Merophy/pectoralis_major/Documents/merophidae-downstroke.jpeg

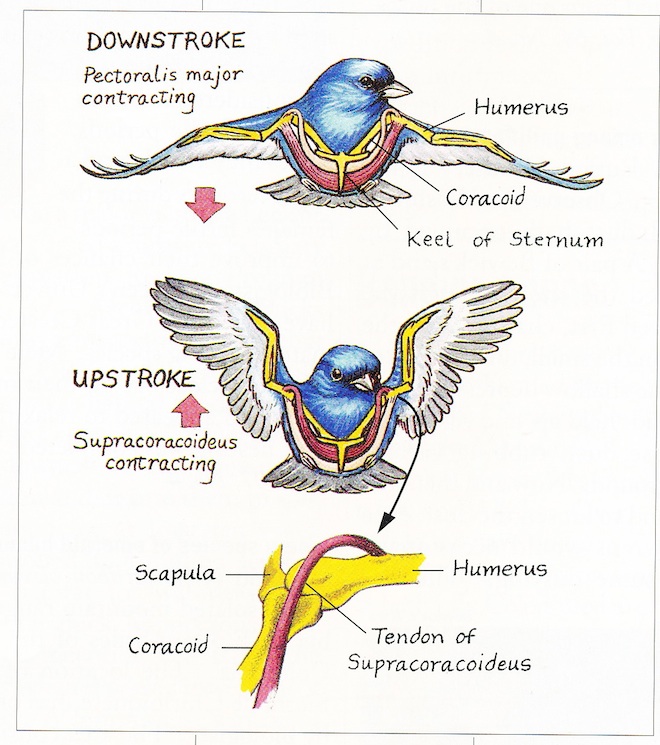
Documents/merophidae-downstroke.jpeg
