Merophy/pectoralis_major/Documents/proprioception.jpeg

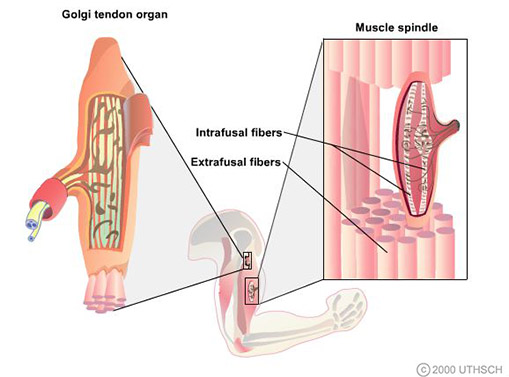
Documents/proprioception.jpeg
