Merophy/pectoralis_major/README.md

# pectoralis_major
The pectoralis is a large muscle that attaches to the humerus of the wing at the deltopectoral crest.
