Merophy/pectoralis_major/Documents/Neuromuscular_junction.jpeg

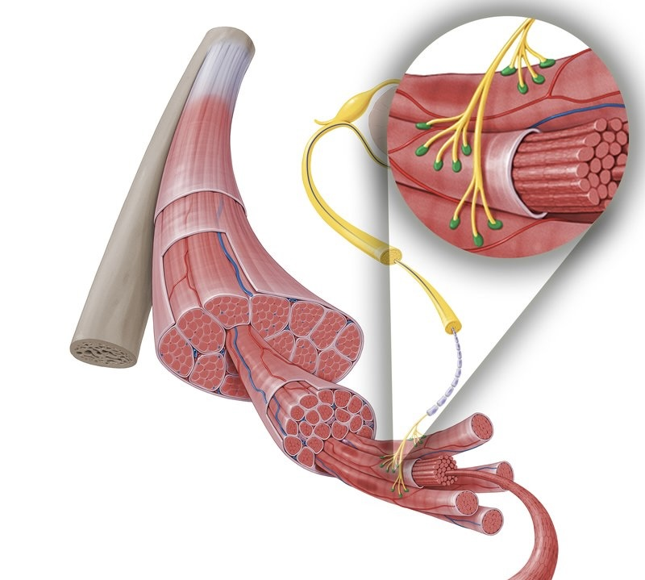
Documents/Neuromuscular_junction.jpeg
