Merophy/pectoralis_major/Circuit Designs/foc.DXF

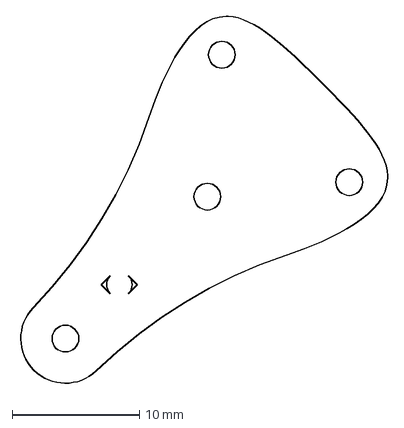
[picture p4: CAD file, 2022-03-30]
Circuit Designs/foc.DXF
29.1 x 29.1 mm
