Merophy/pectoralis_major/Circuit Designs/pectoralis_major.step

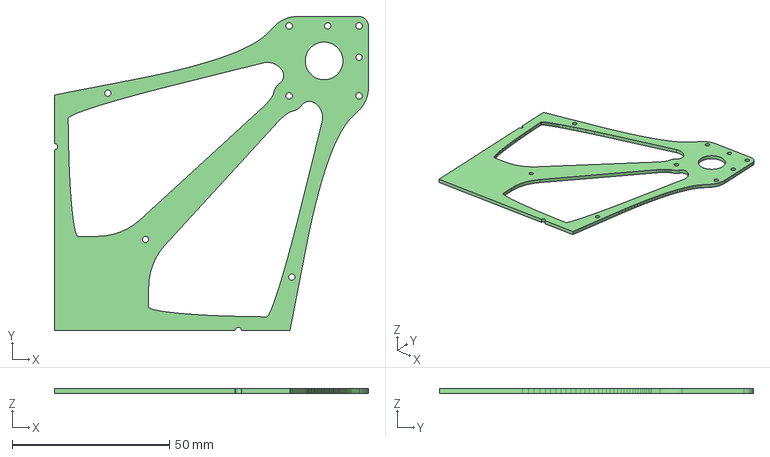
[picture p5: CAD file, 2022-03-06]
Circuit Designs/pectoralis_major.step
100.0 x 100.0 x 1.60 mm
