Merophy/pectoralis_major/Circuit Designs/esc.DXF

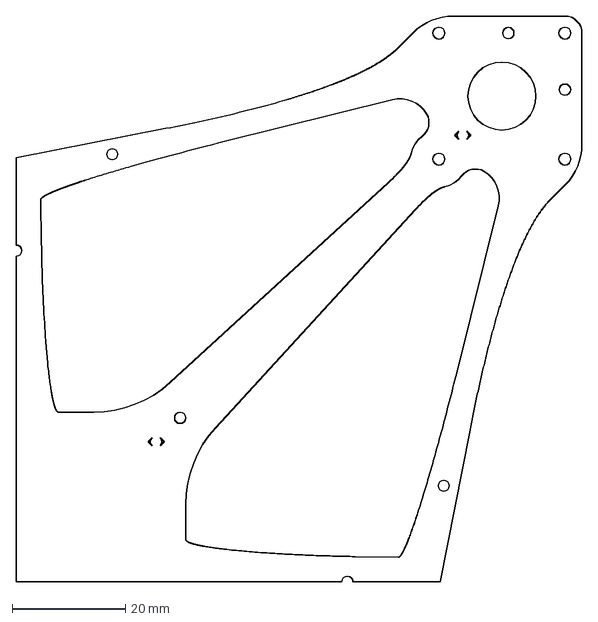
[picture p6: CAD file, 2022-03-06]
Circuit Designs/esc.DXF
100.0 x 100.0 mm
