Merophy/pectoralis_major/Circuit Designs/pectoralis_major.kicad_pcb

## KiCad design Circuit Designs/pectoralis_major.kicad_pcb (2022-04-14)

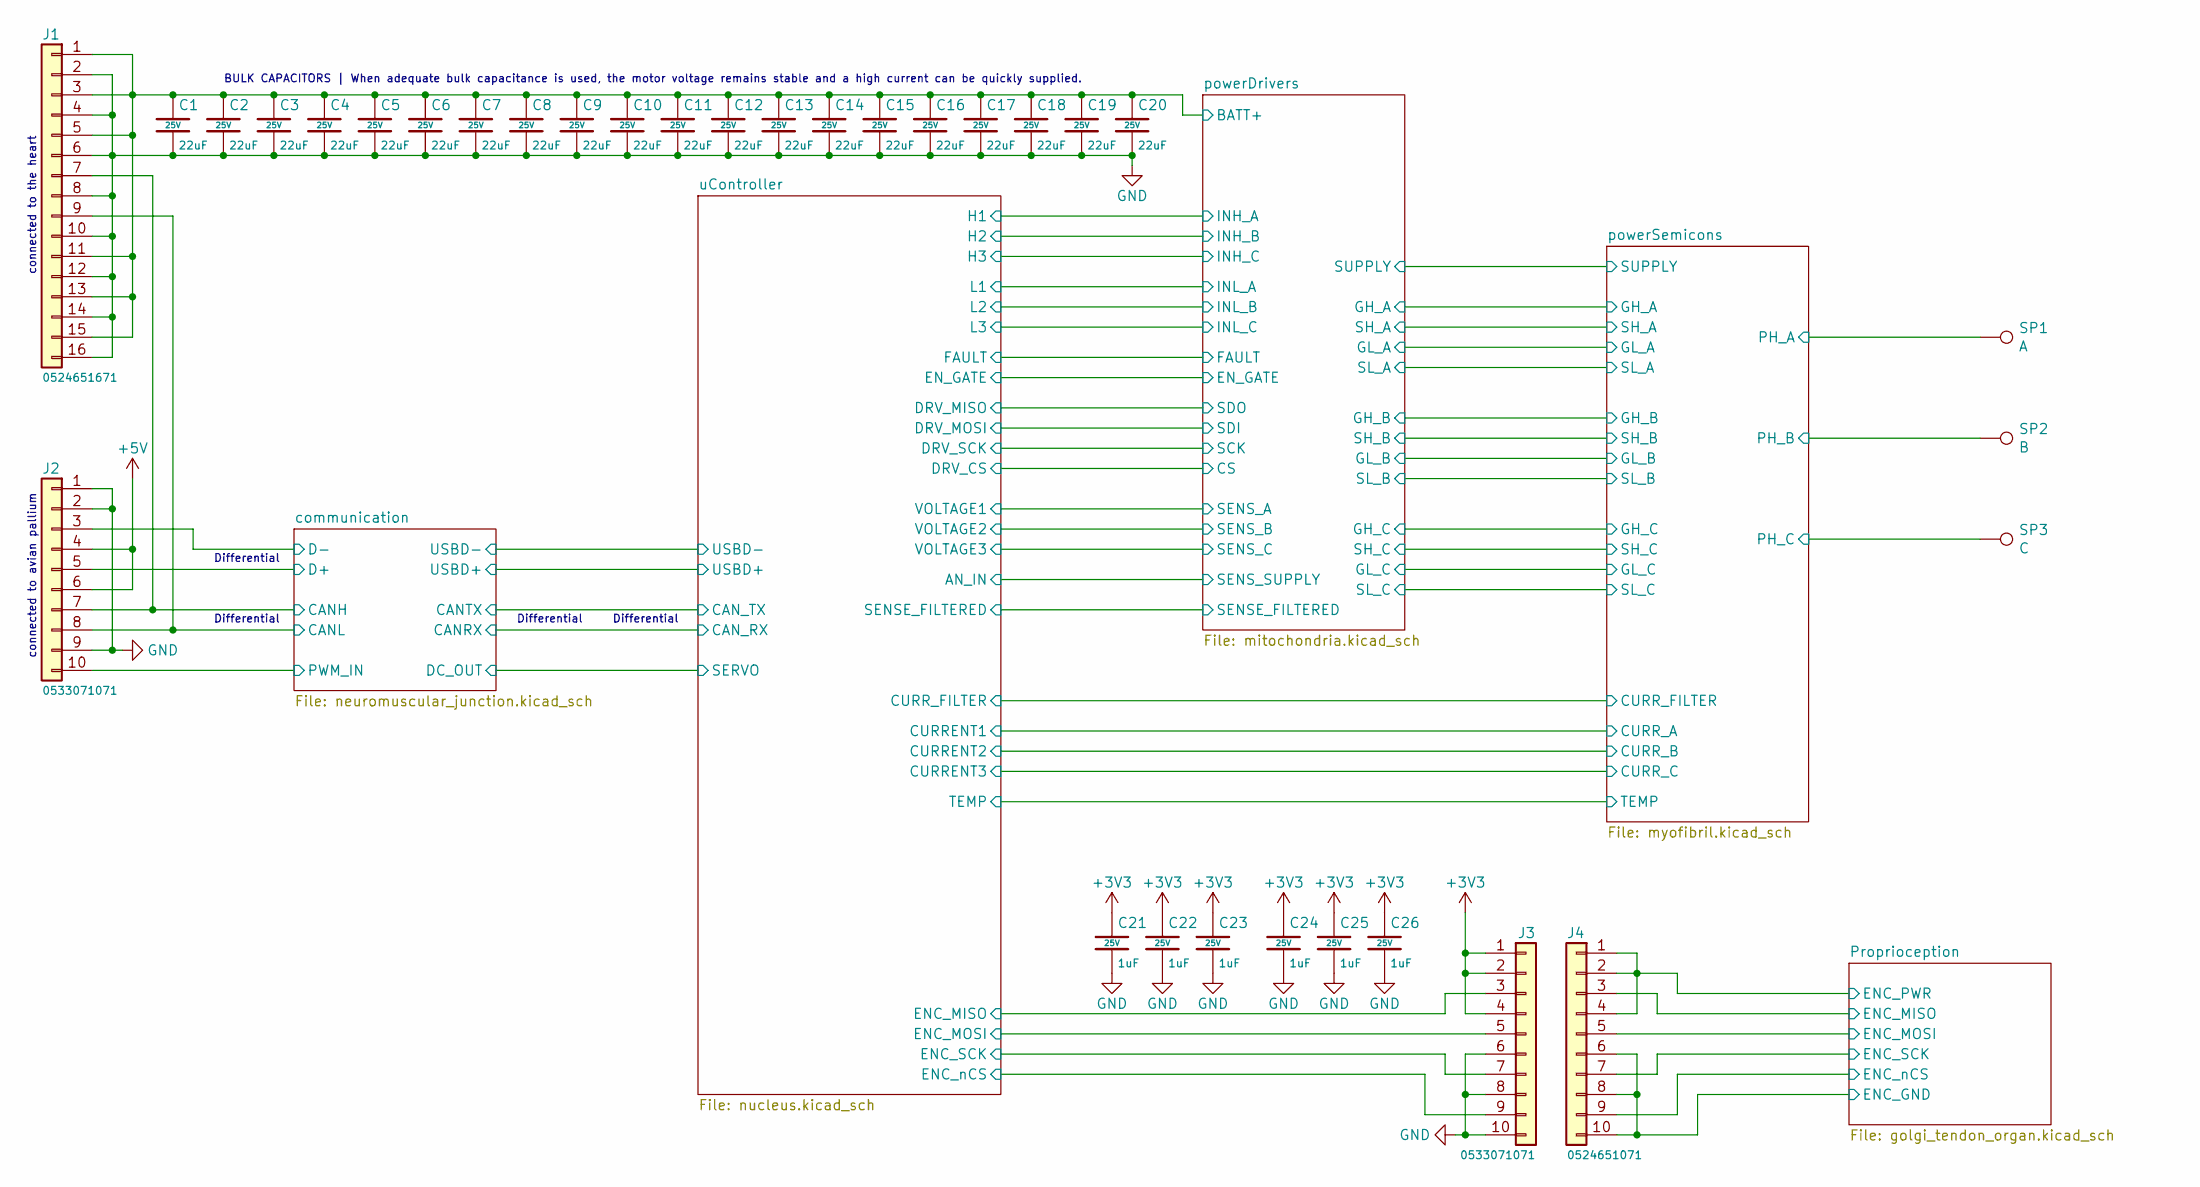
[picture p7: schematic pectoralis_major.kicad_sch, pectoralis major]

Parts:
C1, C2, C3, C4, C5, C6, C7, C8, C9, C10, C11, C12, C13, C14, C15, C16, C17, C18, C19, C20: 22uF; C-0805; Voltage 25V; MFR. Part # CL21A226MAQNNNE; JLCPCB Part # C45783
C21, C22, C23, C24, C25, C26: 1uF; C-0402; Voltage 25V; MFR. Part # CL05A105KA5NQNC; JLCPCB Part # C52923
J1: 0524651671; 524651671; MFR Part # 0524651671; Digikey Part # WM7089CT-ND
J2, J3: 0533071071; MFR Part # 0533071071; Digikey Part # WM8918CT-ND
J4: 0524651071; 524651071; MFR Part # 0524651071; Farnell Part # 2063791
SP1: A; SolderPt_2.5x4mm
SP2: B; SolderPt_2.5x4mm
SP3: C; SolderPt_2.5x4mm

Connections:
+3V3: C21.1, C22.1, C23.1, C24.1, C25.1, C26.1, J3.1, J3.2, J3.4; also elsewhere on the board
+5V: J2.4, J2.6; also elsewhere on the board
/Proprioception/ENC_GND: J4.6, J4.8, J4.10; also elsewhere on the board
/Proprioception/ENC_MISO: J4.3; also elsewhere on the board
/Proprioception/ENC_MOSI: J4.5; also elsewhere on the board
/Proprioception/ENC_PWR: J4.1, J4.2, J4.4; also elsewhere on the board
/Proprioception/ENC_SCK: J4.7; also elsewhere on the board
/Proprioception/ENC_nCS: J4.9; also elsewhere on the board
/communication/CANH: J1.7, J2.7; also elsewhere on the board
/communication/CANL: J1.9, J2.8; also elsewhere on the board
/communication/D+: J2.5; also elsewhere on the board
/communication/D-: J2.3; also elsewhere on the board
/communication/PWM_IN: J2.10; also elsewhere on the board
/powerSemicons/PH_A: SP1.1; also elsewhere on the board
/powerSemicons/PH_B: SP2.1; also elsewhere on the board
/powerSemicons/PH_C: SP3.1; also elsewhere on the board
/uController/ENC_MISO: J3.3; also elsewhere on the board
/uController/ENC_MOSI: J3.5; also elsewhere on the board
/uController/ENC_SCK: J3.7; also elsewhere on the board
/uController/ENC_nCS: J3.9; also elsewhere on the board
GND: C1.2, C2.2, C3.2, C4.2, C5.2, C6.2, C7.2, C8.2, C9.2, C10.2, C11.2, C12.2, C13.2, C14.2, C15.2, C16.2, C17.2, C18.2, C19.2, C20.2, C21.2, C22.2, C23.2, C24.2, C25.2, C26.2, J1.2, J1.4, J1.6, J1.8, J1.10, J1.12, J1.14, J1.16, J2.1, J2.2, J2.9, J3.6, J3.8, J3.10; also elsewhere on the board
PVDD2: C1.1, C2.1, C3.1, C4.1, C5.1, C6.1, C7.1, C8.1, C9.1, C10.1, C11.1, C12.1, C13.1, C14.1, C15.1, C16.1, C17.1, C18.1, C19.1, C20.1, J1.1, J1.3, J1.5, J1.11, J1.13, J1.15; also elsewhere on the board

Notes on the sheet:
Differential
BULK CAPACITORS | When adequate bulk capacitance is used, the motor voltage remains stable and a high current can be quickly supplied.
connected to avian pallium
connected to the heart

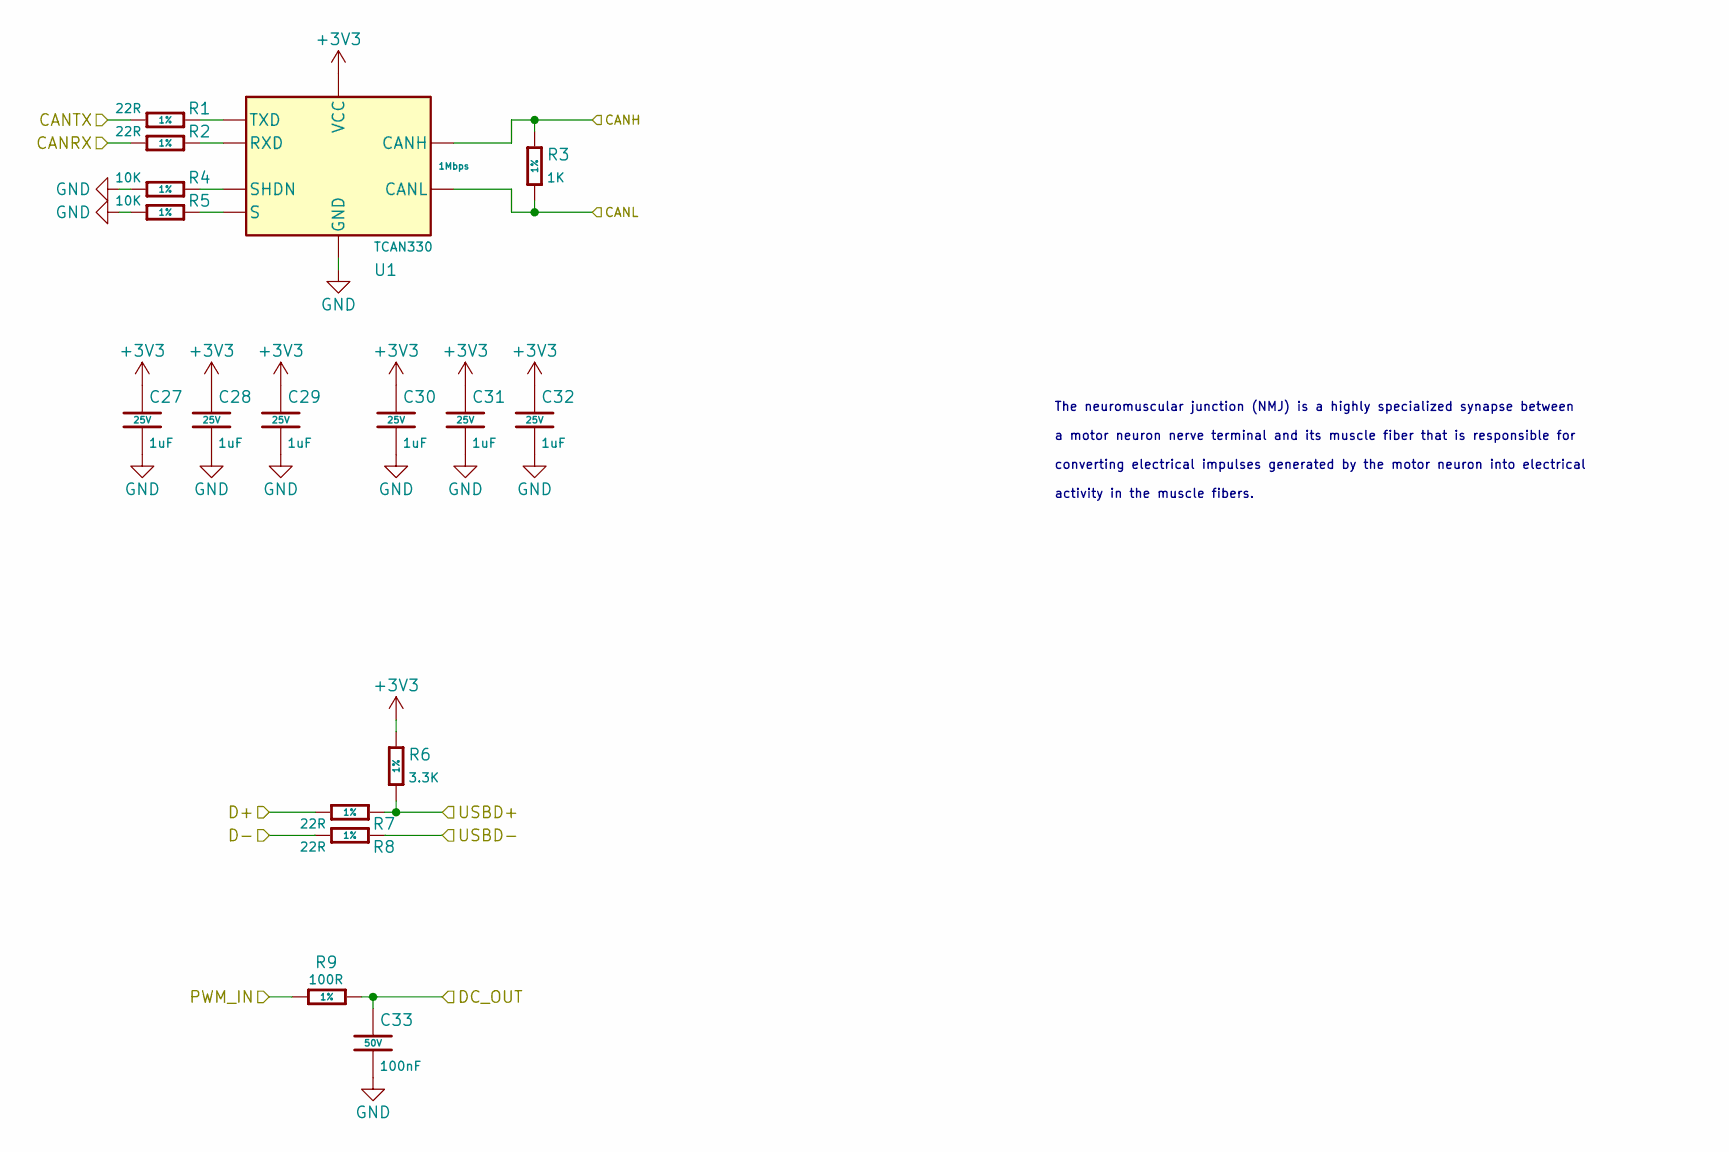
[picture p8: schematic neuromuscular_junction.kicad_sch, pectoralis major]

Parts:
C27, C28, C29, C30, C31, C32: 1uF; C-0402; Voltage 25V; MFR. Part # CL05A105KA5NQNC; JLCPCB Part # C52923
C33: 100nF; C-0402; Voltage 50V; MFR. Part # CL05B104KB54PNC; JLCPCB Part # C307331
R1, R2, R7, R8: 22R; R-0402; Tolerance 1%; MFR. Part # 0402WGF220JTCE; JLCPCB Part # C25092
R3: 1K; R-0402; Tolerance 1%; MFR. Part # 0402WGF1001TCE; JLCPCB Part # C11702
R4, R5: 10K; R-0402; Tolerance 1%; MFR. Part # 0402WGF1002TCE; JLCPCB Part # C25744
R6: 3.3K; R-0402; Tolerance 1%; MFR. Part # 0402WGF3301TCE; JLCPCB Part # C25890
R9: 100R; R-0402; Tolerance 1%; MFR. Part # 0402WGF1000TCE; JLCPCB Part # C25076
U1: TCAN330; TSOT-23-8; MFR. Part # TCAN330GDCNR; Digikey Part # 296-TCAN330GDCNRCT-ND

Connections:
+3V3: C27.1, C28.1, C29.1, C30.1, C31.1, C32.1, R6.1, U1.3 (VCC); also elsewhere on the board
/communication/CANH: R3.1, U1.7 (CANH); also elsewhere on the board
/communication/CANL: R3.2, U1.6 (CANL); also elsewhere on the board
/communication/CANRX: R2.1; also elsewhere on the board
/communication/CANTX: R1.1; also elsewhere on the board
/communication/D+: R7.1; also elsewhere on the board
/communication/D-: R8.1; also elsewhere on the board
/communication/DC_OUT: C33.1, R9.2; also elsewhere on the board
/communication/PWM_IN: R9.1; also elsewhere on the board
/communication/USBD+: R6.2, R7.2; also elsewhere on the board
/communication/USBD-: R8.2; also elsewhere on the board
GND: C27.2, C28.2, C29.2, C30.2, C31.2, C32.2, C33.2, R4.1, R5.1, U1.2 (GND); also elsewhere on the board
unnamed: R1.2, U1.1 (TXD)
unnamed: R2.2, U1.4 (RXD)
unnamed: R4.2, U1.5 (SHDN)
unnamed: R5.2, U1.8 (S)

Notes on the sheet:
The neuromuscular junction (NMJ) is a highly specialized synapse between a motor neuron nerve terminal and its muscle fiber that is responsible for converting electrical impulses generated by the motor neuron into electrical activity in the muscle fibers.

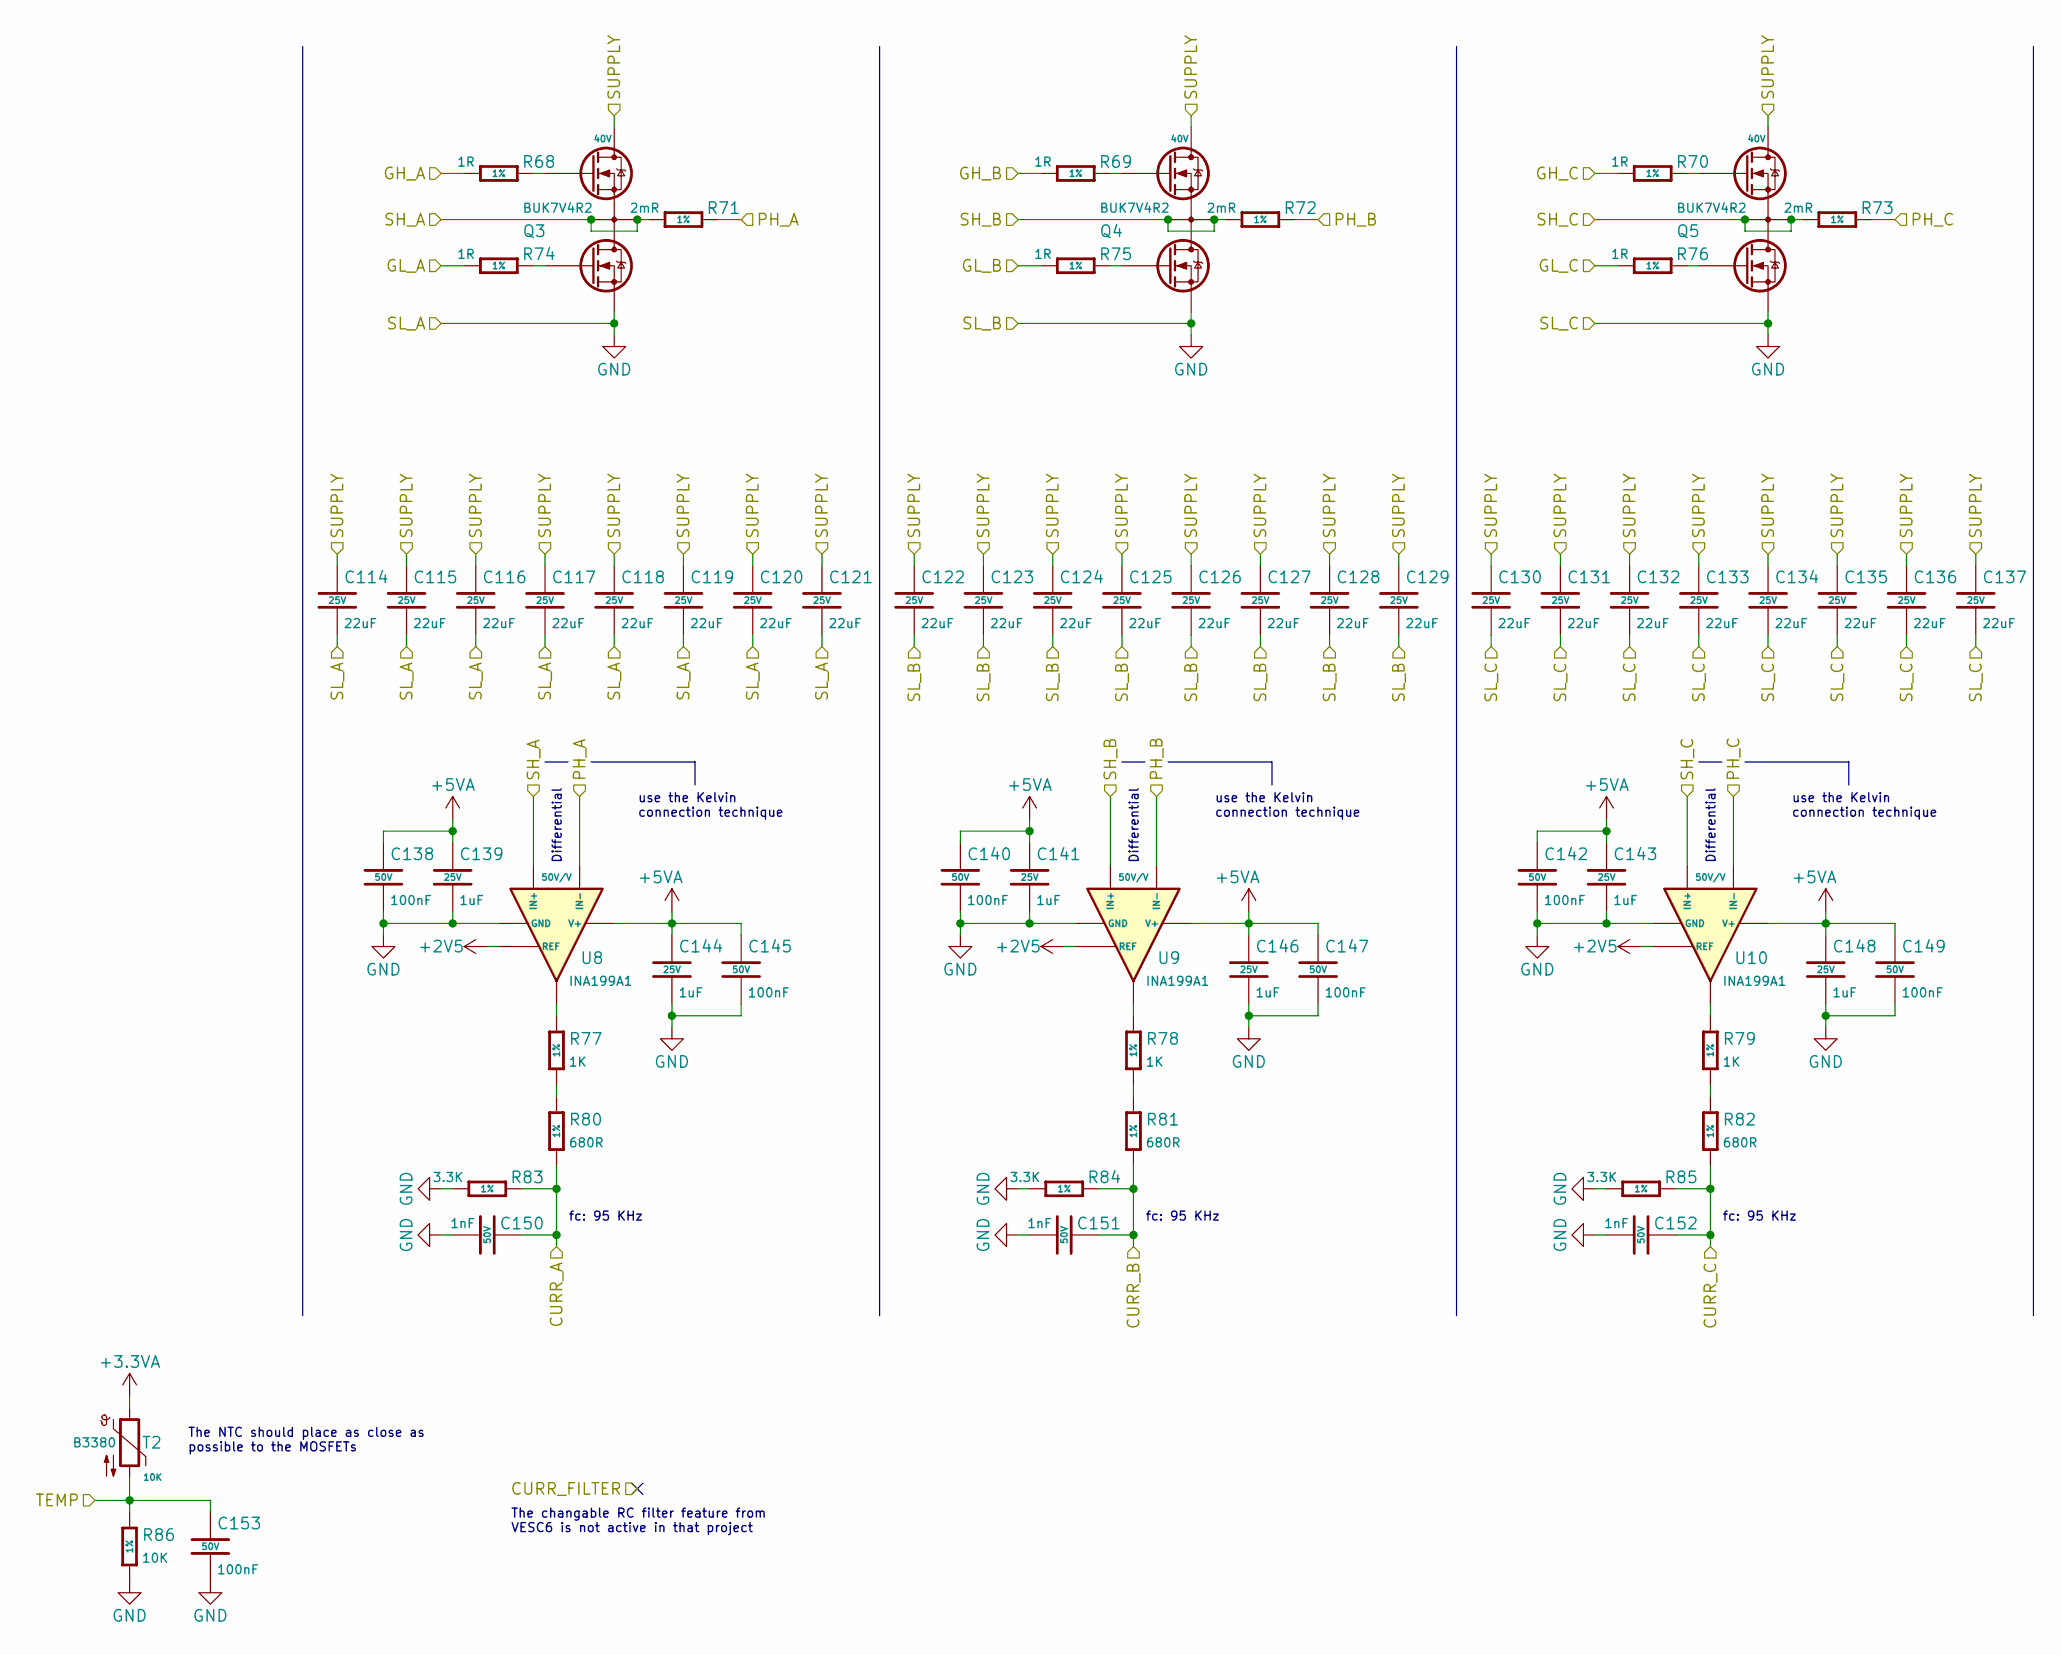
[picture p9: schematic myofibril.kicad_sch, pectoralis major]

Parts:
C114, C115, C116, C117, C118, C119, C120, C121, C122, C123, C124, C125, C126, C127, C128, C129, C130, C131, C132, C133, C134, C135, C136, C137: 22uF; C-0805; Voltage 25V; MFR. Part # CL21A226MAQNNNE; JLCPCB Part # C45783
C138, C140, C142, C145, C147, C149, C153: 100nF; C-0402; Voltage 50V; MFR. Part # CL05B104KB54PNC; JLCPCB Part # C307331
C139, C141, C143, C144, C146, C148: 1uF; C-0402; Voltage 25V; MFR. Part # CL05A105KA5NQNC; JLCPCB Part # C52923
C150, C151, C152: 1nF; C-0402; Voltage 50V; MFR. Part # 0402B102K500NT; JLCPCB Part # C1523
Q3, Q4, Q5: BUK7V4R2; SOT-1205; MFR. Part # BUK7V4R2; Digikey Part # 1727-BUK7V4R2-40HXCT-ND
R68, R69, R70, R74, R75, R76: 1R; R-0402; Tolerance 1%; MFR. Part # 0402WGF100KTCE; JLCPCB Part # C25086
R71, R72, R73: 2mR; R-1206; Tolerance 1%; MFR. Part # PA1206FRM470R002L; JLCPCB Part # C728295
R77, R78, R79: 1K; R-0402; Tolerance 1%; MFR. Part # 0402WGF1001TCE; JLCPCB Part # C11702
R80, R81, R82: 680R; R-0402; Tolerance 1%; MFR. Part # 0402WGF6800TCE; JLCPCB Part # C25130
R83, R84, R85: 3.3K; R-0402; Tolerance 1%; MFR. Part # 0402WGF3301TCE; JLCPCB Part # C25890
R86: 10K; R-0402; Tolerance 1%; MFR. Part # 0402WGF1002TCE; JLCPCB Part # C25744
T2: B3380; R-0402; MFR. Part # NCP15XH103F03RC; JLCPCB Part # C77131
U8, U9, U10: INA199A1; SOT-363; MFR. Part # INA199A1DCKR; JLCPCB Part # C59135

Connections:
+2V5: U8.1 (REF), U9.1 (REF), U10.1 (REF); also elsewhere on the board
+3.3VA: T2.1; also elsewhere on the board
+5VA: C138.1, C139.1, C140.1, C141.1, C142.1, C143.1, C144.1, C145.1, C146.1, C147.1, C148.1, C149.1, U8.3 (V+), U9.3 (V+), U10.3 (V+); also elsewhere on the board
/powerDrivers/GH_A: R68.1; also elsewhere on the board
/powerDrivers/GH_B: R69.1; also elsewhere on the board
/powerDrivers/GH_C: R70.1; also elsewhere on the board
/powerDrivers/GL_A: R74.1; also elsewhere on the board
/powerDrivers/GL_B: R75.1; also elsewhere on the board
/powerDrivers/GL_C: R76.1; also elsewhere on the board
/powerDrivers/SH_A: Q3.3 (S1), Q3.6 (S1/D2), R71.1, U8.4 (IN+); also elsewhere on the board
/powerDrivers/SH_B: Q4.3 (S1), Q4.6 (S1/D2), R72.1, U9.4 (IN+); also elsewhere on the board
/powerDrivers/SH_C: Q5.3 (S1), Q5.6 (S1/D2), R73.1, U10.4 (IN+); also elsewhere on the board
/powerSemicons/CURR_A: C150.2, R80.2, R83.2; also elsewhere on the board
/powerSemicons/CURR_B: C151.2, R81.2, R84.2; also elsewhere on the board
/powerSemicons/CURR_C: C152.2, R82.2, R85.2; also elsewhere on the board
/powerSemicons/PH_A: R71.2, U8.5 (IN-); also elsewhere on the board
/powerSemicons/PH_B: R72.2, U9.5 (IN-); also elsewhere on the board
/powerSemicons/PH_C: R73.2, U10.5 (IN-); also elsewhere on the board
/powerSemicons/TEMP: C153.1, R86.1, T2.2; also elsewhere on the board
GND: C114.2, C115.2, C116.2, C117.2, C118.2, C119.2, C120.2, C121.2, C122.2, C123.2, C124.2, C125.2, C126.2, C127.2, C128.2, C129.2, C130.2, C131.2, C132.2, C133.2, C134.2, C135.2, C136.2, C137.2, C138.2, C139.2, C140.2, C141.2, C142.2, C143.2, C144.2, C145.2, C146.2, C147.2, C148.2, C149.2, C150.1, C151.1, C152.1, C153.2, Q3.1 (S2), Q4.1 (S2), Q5.1 (S2), R83.1, R84.1, R85.1, R86.2, U8.2 (GND), U9.2 (GND), U10.2 (GND); also elsewhere on the board
unnamed: Q3.2 (G2), R74.2
unnamed: Q3.4 (G1), R68.2
unnamed: Q4.2 (G2), R75.2
unnamed: Q4.4 (G1), R69.2
unnamed: Q5.2 (G2), R76.2
unnamed: Q5.4 (G1), R70.2
unnamed: R77.1, U8.6
unnamed: R77.2, R80.1
unnamed: R78.1, U9.6
unnamed: R78.2, R81.1
unnamed: R79.1, U10.6
unnamed: R79.2, R82.1
PVDD2: C114.1, C115.1, C116.1, C117.1, C118.1, C119.1, C120.1, C121.1, C122.1, C123.1, C124.1, C125.1, C126.1, C127.1, C128.1, C129.1, C130.1, C131.1, C132.1, C133.1, C134.1, C135.1, C136.1, C137.1, Q3.5 (D1), Q4.5 (D1), Q5.5 (D1); also elsewhere on the board

Notes on the sheet:
Differential
The changable RC filter feature from VESC6 is not active in that project
use the Kelvin connection technique
fc: 95 KHz
The NTC should place as close as possible to the MOSFETs

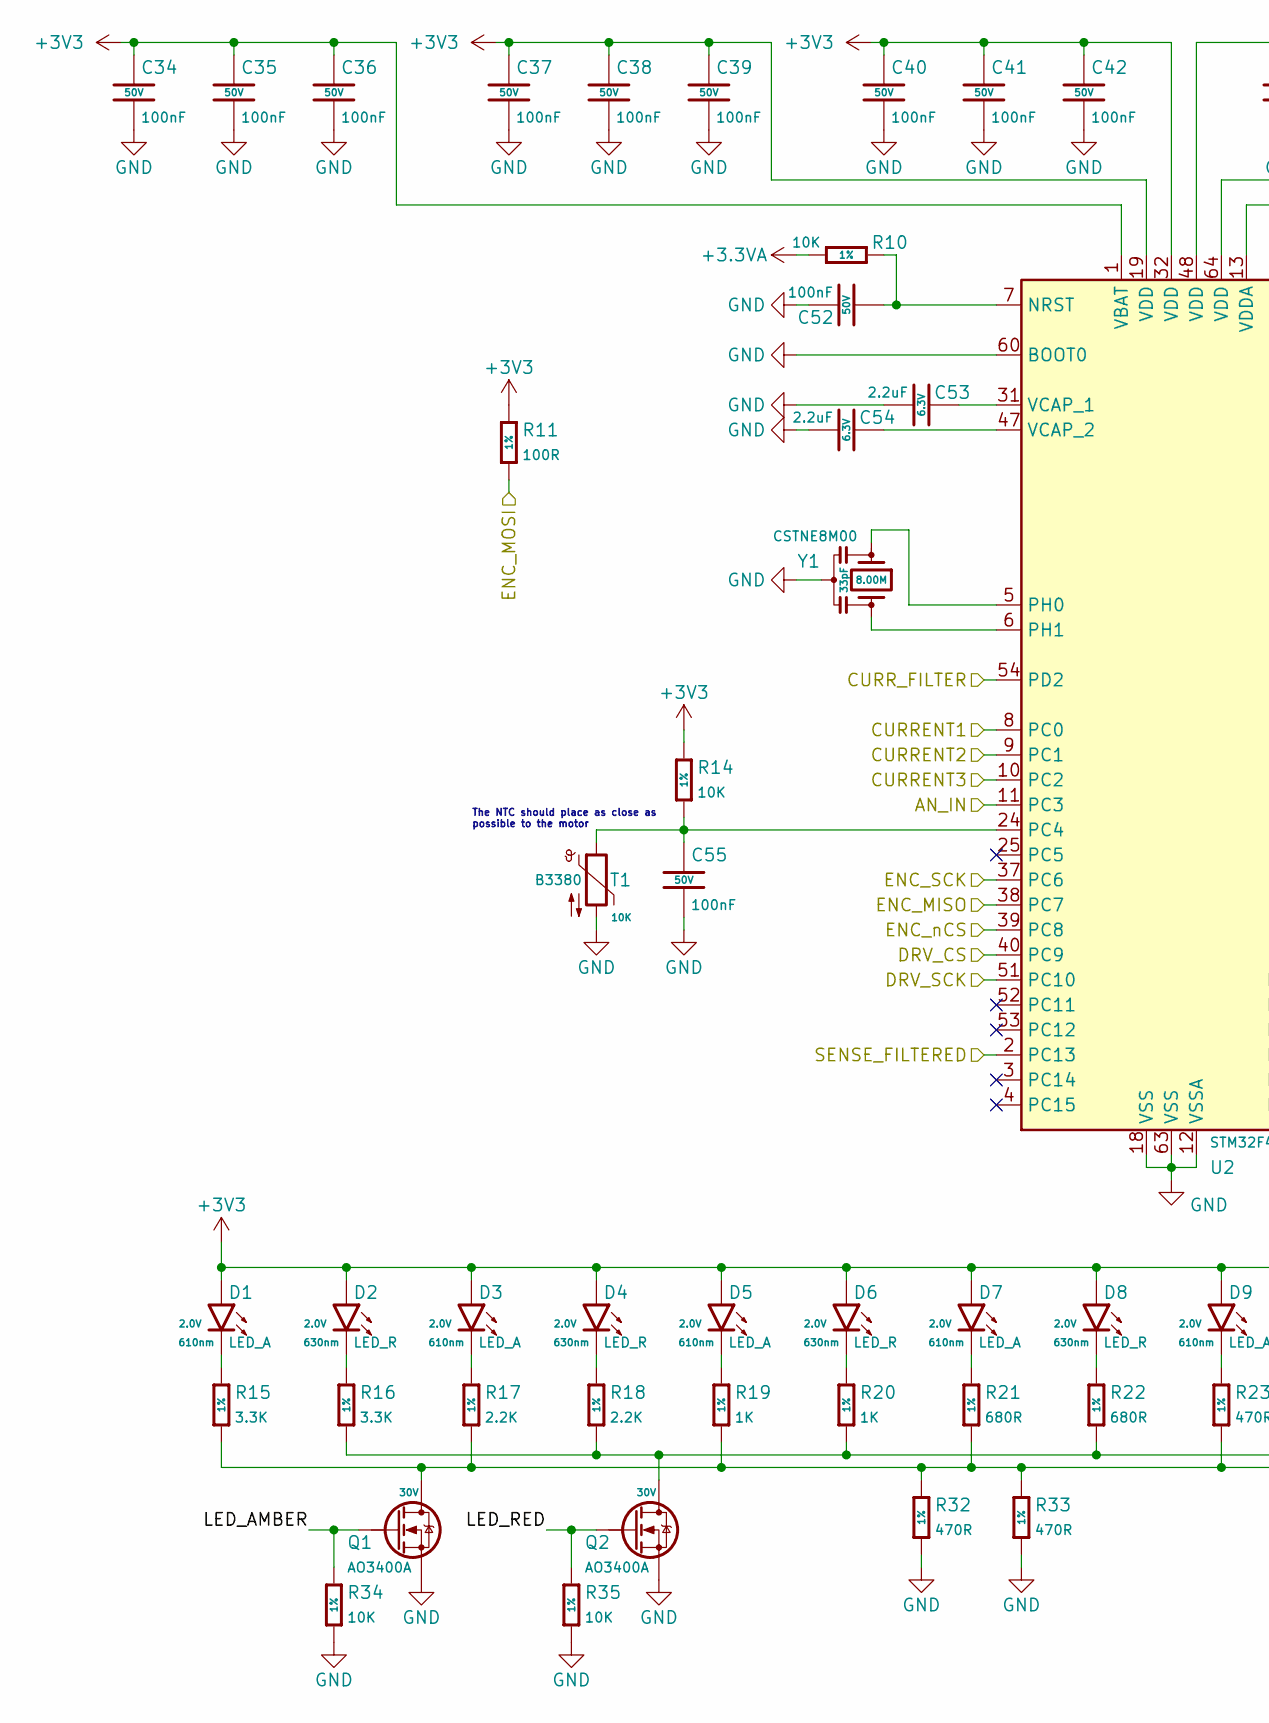
[picture p10: schematic nucleus.kicad_sch, pectoralis major, part in row 1, column 1]

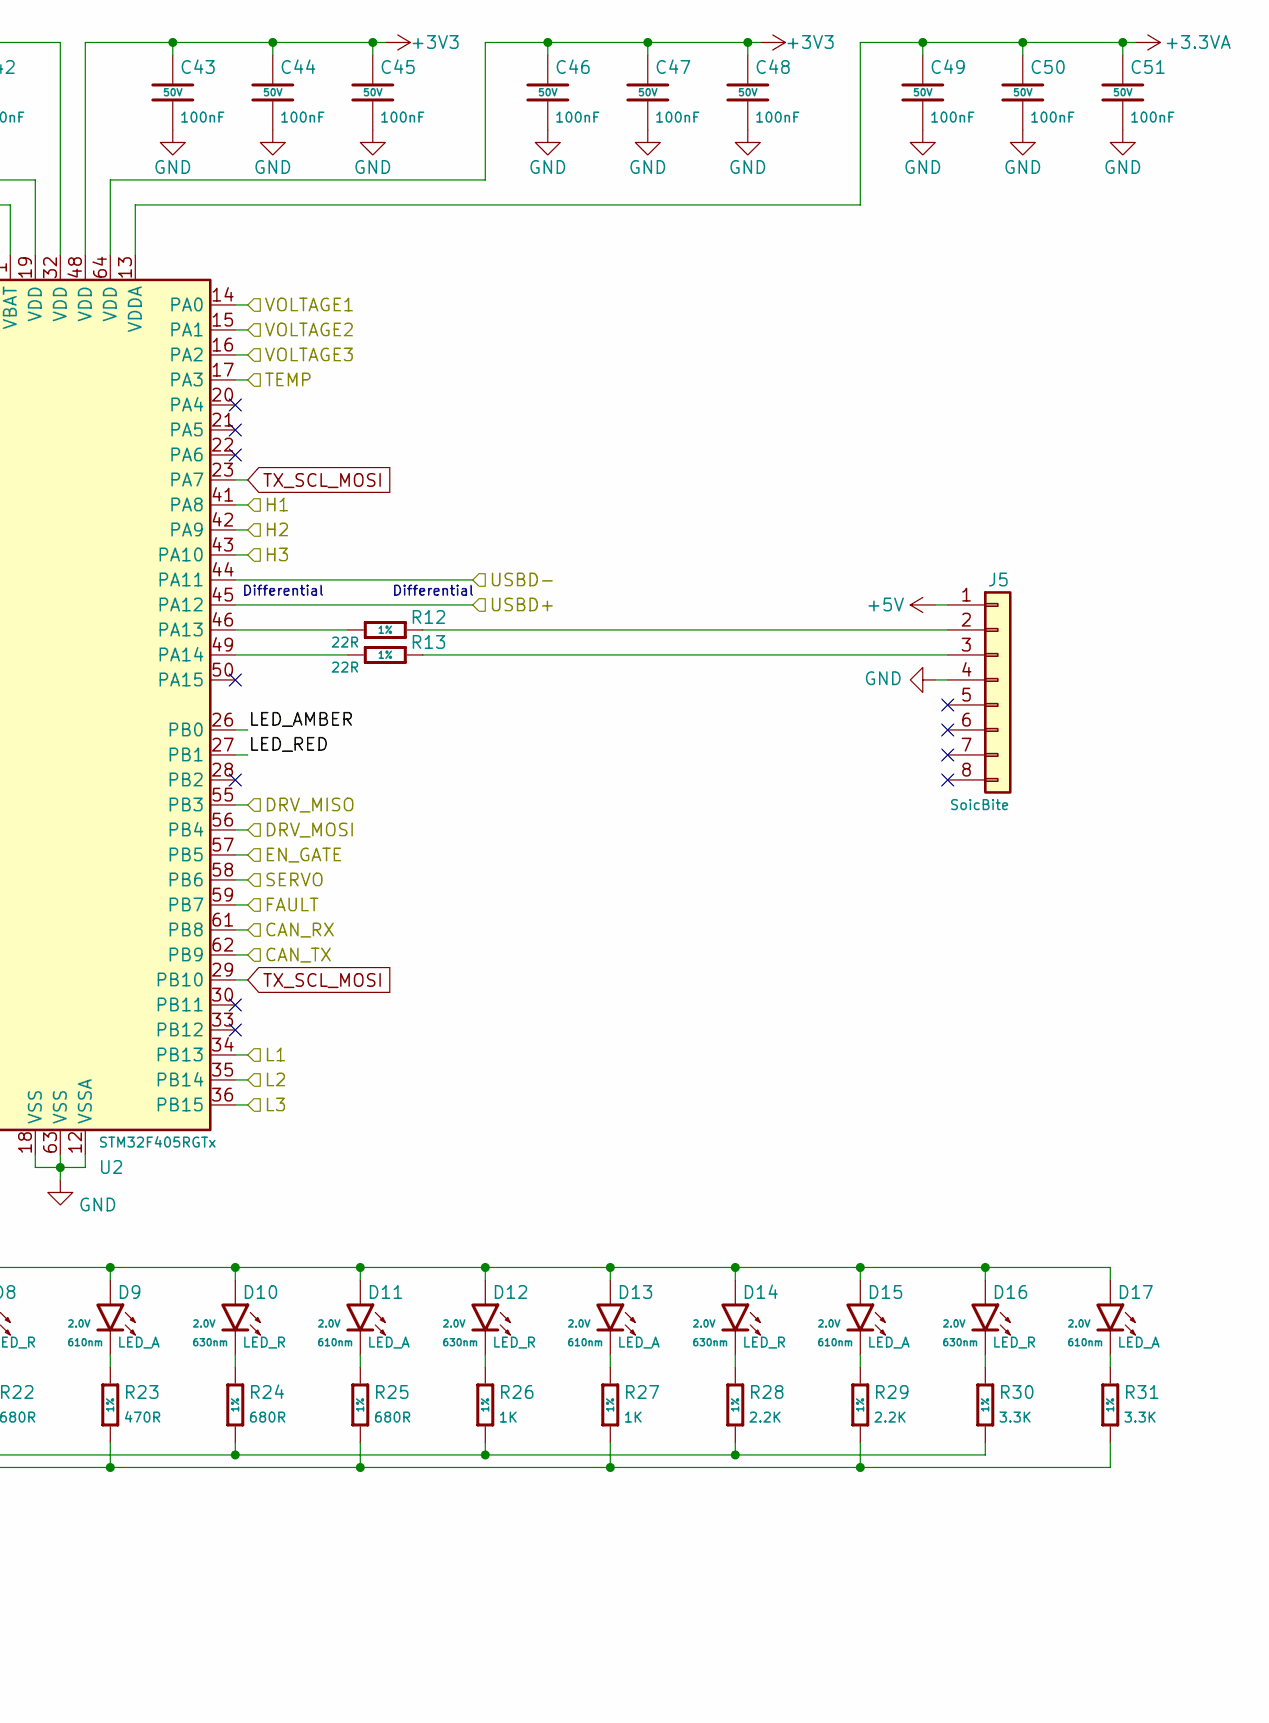
[picture p11: schematic nucleus.kicad_sch, pectoralis major, part in row 1, column 2]

Parts:
C34, C35, C36, C37, C38, C39, C40, C41, C42, C43, C44, C45, C46, C47, C48, C49, C50, C51, C52, C55: 100nF; C-0402; Voltage 50V; MFR. Part # CL05B104KB54PNC; JLCPCB Part # C307331
C53, C54: 2.2uF; C-0402; Voltage 6.3V; MFR. Part # CL05A225MQ5NSNC; JLCPCB Part # C12530
D1, D3, D5, D7, D9, D11, D13, D15, D17: LED_A; LED-0603; MFR. Part # BL-HJC36A-AV-TRB; JLCPCB Part # C138546
D2, D4, D6, D8, D10, D12, D14, D16: LED_R; LED-0603; MFR. Part # KT-0603R; JLCPCB Part # C2286
J5: SoicBite
Q1, Q2: AO3400A; SOT-23; MFR. Part # AO3400A; JLCPCB Part # C20917
R10, R14, R34, R35: 10K; R-0402; Tolerance 1%; MFR. Part # 0402WGF1002TCE; JLCPCB Part # C25744
R11: 100R; R-0402; Tolerance 1%; MFR. Part # 0402WGF1000TCE; JLCPCB Part # C25076
R12, R13: 22R; R-0402; Tolerance 1%; MFR. Part # 0402WGF220JTCE; JLCPCB Part # C25092
R15, R16, R30, R31: 3.3K; R-0402; Tolerance 1%; MFR. Part # 0402WGF3301TCE; JLCPCB Part # C25890
R17, R18, R28, R29: 2.2K; R-0402; Tolerance 1%; MFR. Part # 0402WGF2201TCE; JLCPCB Part # C25879
R19, R20, R26, R27: 1K; R-0402; Tolerance 1%; MFR. Part # 0402WGF1001TCE; JLCPCB Part # C11702
R21, R22, R24, R25: 680R; R-0402; Tolerance 1%; MFR. Part # 0402WGF6800TCE; JLCPCB Part # C25130
R23, R32, R33: 470R; R-0402; Tolerance 1%; MFR. Part # 0402WGF4700TCE; JLCPCB Part # C25117
T1: B3380; R-0402; MFR. Part # NCP15XH103F03RC; JLCPCB Part # C77131
U2: STM32F405RGTx; LQFP-64; MFR. Part # STM32F405RGT6; Digikey Part # 497-11767-ND
Y1: CSTNE8M00; CSTNE; MFR. Part # CSTNE8M00G550000R0; Digikey Part # 490-17958-1-ND

Connections:
+3.3VA: C49.1, C50.1, C51.1, R10.1, U2.13 (VDDA); also elsewhere on the board
+3V3: C34.1, C35.1, C36.1, C37.1, C38.1, C39.1, C40.1, C41.1, C42.1, C43.1, C44.1, C45.1, C46.1, C47.1, C48.1, D1.2 (A), D2.2 (A), D3.2 (A), D4.2 (A), D5.2 (A), D6.2 (A), D7.2 (A), D8.2 (A), D9.2 (A), D10.2 (A), D11.2 (A), D12.2 (A), D13.2 (A), D14.2 (A), D15.2 (A), D16.2 (A), D17.2 (A), R11.1, R14.1, U2.1 (VBAT), U2.19 (VDD), U2.32 (VDD), U2.48 (VDD), U2.64 (VDD); also elsewhere on the board
+5V: J5.1; also elsewhere on the board
/communication/CANRX: U2.61 (PB8); also elsewhere on the board
/communication/CANTX: U2.62 (PB9); also elsewhere on the board
/communication/DC_OUT: U2.58 (PB6); also elsewhere on the board
/communication/USBD+: U2.45 (PA12); also elsewhere on the board
/communication/USBD-: U2.44 (PA11); also elsewhere on the board
/powerDrivers/CS: U2.40 (PC9); also elsewhere on the board
/powerDrivers/EN_GATE: U2.57 (PB5); also elsewhere on the board
/powerDrivers/FAULT: U2.59 (PB7); also elsewhere on the board
/powerDrivers/INH_A: U2.41 (PA8); also elsewhere on the board
/powerDrivers/INH_B: U2.42 (PA9); also elsewhere on the board
/powerDrivers/INH_C: U2.43 (PA10); also elsewhere on the board
/powerDrivers/INL_A: U2.34 (PB13); also elsewhere on the board
/powerDrivers/INL_B: U2.35 (PB14); also elsewhere on the board
/powerDrivers/INL_C: U2.36 (PB15); also elsewhere on the board
/powerDrivers/SCK: U2.51 (PC10); also elsewhere on the board
/powerDrivers/SDI: U2.56 (PB4); also elsewhere on the board
/powerDrivers/SDO: U2.55 (PB3); also elsewhere on the board
/powerDrivers/SENSE_FILTERED: U2.2 (PC13)
/powerDrivers/SENS_A: U2.14 (PA0); also elsewhere on the board
/powerDrivers/SENS_B: U2.15 (PA1); also elsewhere on the board
/powerDrivers/SENS_C: U2.16 (PA2); also elsewhere on the board
/powerDrivers/SENS_SUPPLY: U2.11 (PC3); also elsewhere on the board
/powerSemicons/CURR_A: U2.8 (PC0); also elsewhere on the board
/powerSemicons/CURR_B: U2.9 (PC1); also elsewhere on the board
/powerSemicons/CURR_C: U2.10 (PC2); also elsewhere on the board
/powerSemicons/CURR_FILTER: U2.54 (PD2)
/powerSemicons/TEMP: U2.17 (PA3); also elsewhere on the board
/uController/ENC_MISO: U2.38 (PC7); also elsewhere on the board
/uController/ENC_MOSI: R11.2; also elsewhere on the board
/uController/ENC_SCK: U2.37 (PC6); also elsewhere on the board
/uController/ENC_nCS: U2.39 (PC8); also elsewhere on the board
/uController/LED_AMBER: Q1.1 (G), R34.1, U2.26 (PB0)
/uController/LED_RED: Q2.1 (G), R35.1, U2.27 (PB1)
GND: C34.2, C35.2, C36.2, C37.2, C38.2, C39.2, C40.2, C41.2, C42.2, C43.2, C44.2, C45.2, C46.2, C47.2, C48.2, C49.2, C50.2, C51.2, C52.1, C53.1, C54.1, C55.2, J5.4, Q1.2 (S), Q2.2 (S), R32.2, R33.2, R34.2, R35.2, T1.2, U2.12 (VSSA), U2.18 (VSS), U2.60 (BOOT0), U2.63 (VSS), Y1.2; also elsewhere on the board
unnamed: C52.2, R10.2, U2.7 (NRST)
unnamed: C53.2, U2.31 (VCAP_1)
unnamed: C54.2, U2.47 (VCAP_2)
unnamed: C55.1, R14.2, T1.1, U2.24 (PC4)
unnamed: D1.1 (K), R15.1
unnamed: D2.1 (K), R16.1
unnamed: D3.1 (K), R17.1
unnamed: D4.1 (K), R18.1
unnamed: D5.1 (K), R19.1
unnamed: D6.1 (K), R20.1
unnamed: D7.1 (K), R21.1
unnamed: D8.1 (K), R22.1
unnamed: D9.1 (K), R23.1
unnamed: D10.1 (K), R24.1
unnamed: D11.1 (K), R25.1
unnamed: D12.1 (K), R26.1
unnamed: D13.1 (K), R27.1
unnamed: D14.1 (K), R28.1
unnamed: D15.1 (K), R29.1
unnamed: D16.1 (K), R30.1
unnamed: D17.1 (K), R31.1
unnamed: J5.2, R12.2
unnamed: J5.3, R13.2
unnamed: Q1.3 (D), R15.2, R17.2, R19.2, R21.2, R23.2, R25.2, R27.2, R29.2, R31.2, R32.1, R33.1
unnamed: Q2.3 (D), R16.2, R18.2, R20.2, R22.2, R24.2, R26.2, R28.2, R30.2
unnamed: R12.1, U2.46 (PA13)
unnamed: R13.1, U2.49 (PA14)
unnamed: U2.5 (PH0), Y1.1
unnamed: U2.6 (PH1), Y1.3
TX_SCL_MOSI: U2.23 (PA7), U2.29 (PB10)

Notes on the sheet:
The NTC should place as close as possible to the motor
Differential
