Merophy/pectoralis_major/Circuit Designs/pectoralis_major.kicad_pcb

## KiCad design Circuit Designs/pectoralis_major.kicad_pcb (continued)

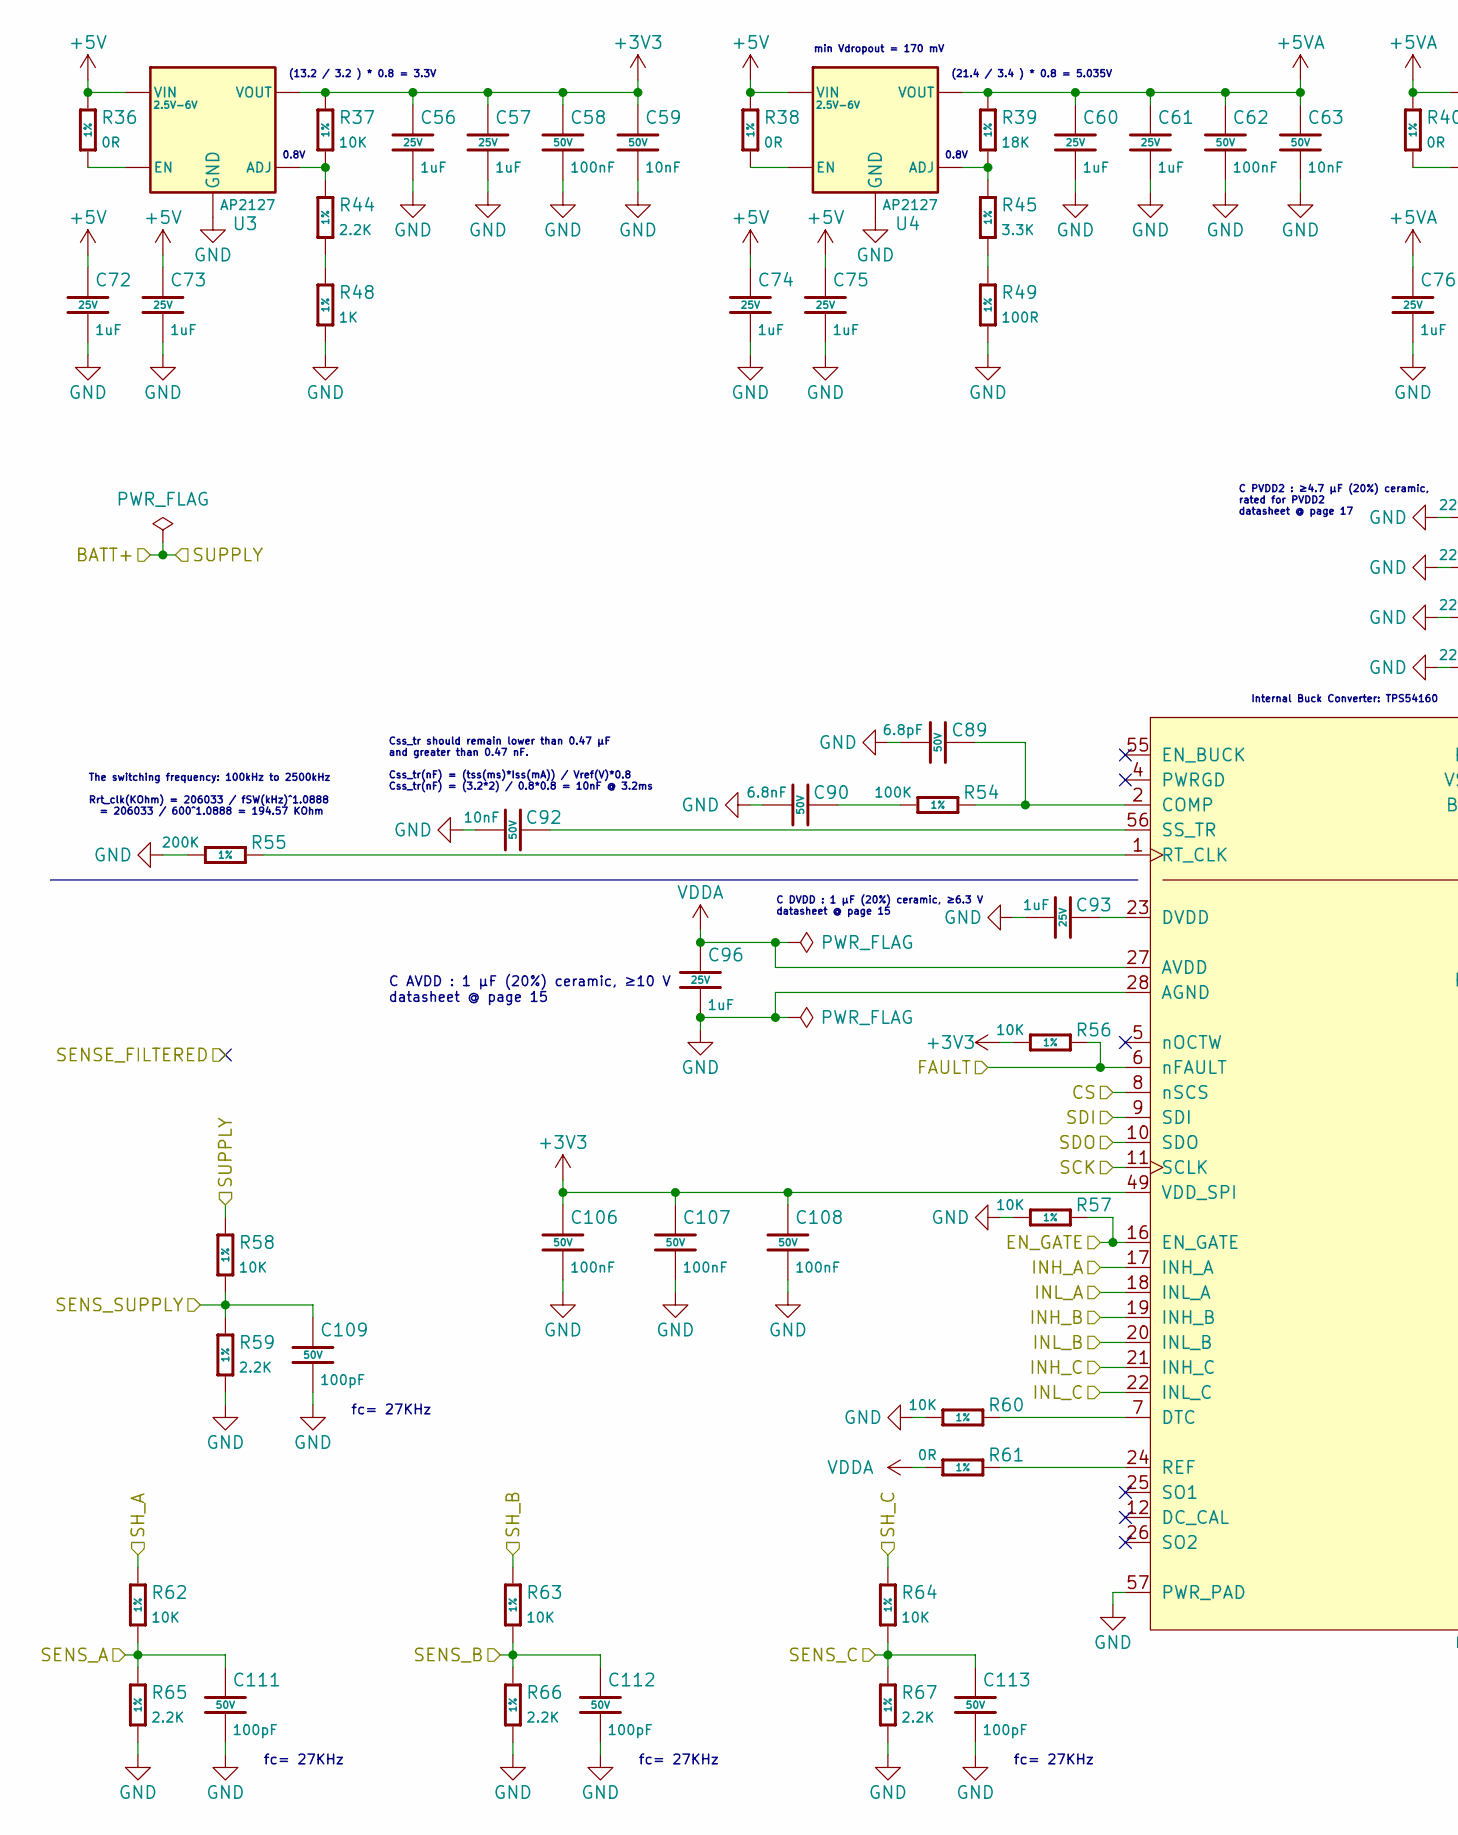
[picture p12: schematic mitochondria.kicad_sch, pectoralis major, part in row 1, column 1]

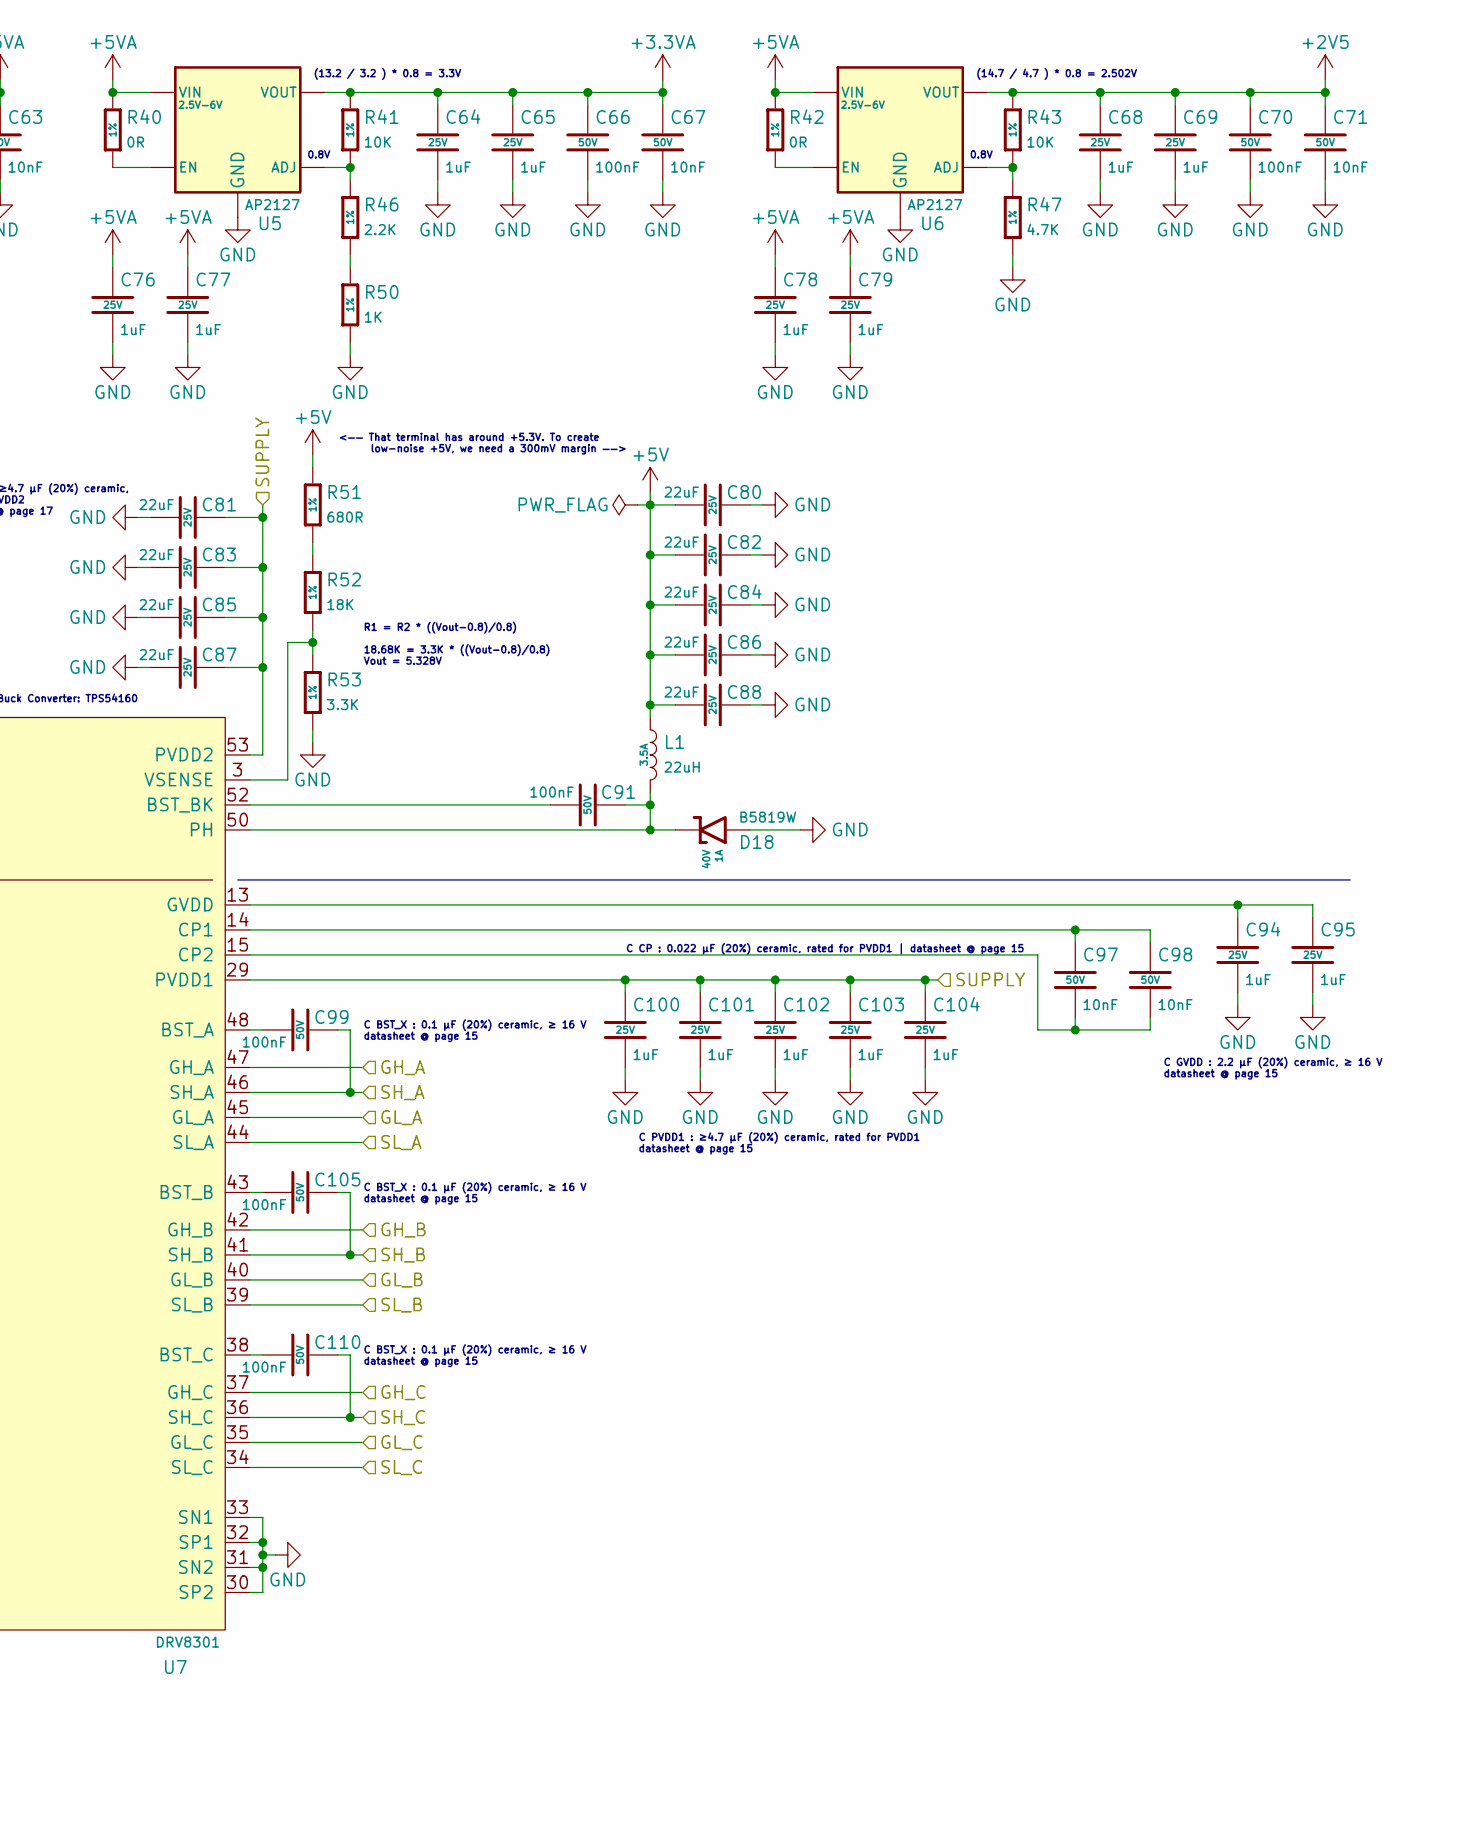
[picture p13: schematic mitochondria.kicad_sch, pectoralis major, part in row 1, column 2]

Parts:
C56, C57, C60, C61, C64, C65, C68, C69, C72, C73, C74, C75, C76, C77, C78, C79, C93, C94, C95, C96, C100, C101, C102, C103, C104: 1uF; C-0402; Voltage 25V; MFR. Part # CL05A105KA5NQNC; JLCPCB Part # C52923
C58, C62, C66, C70, C91, C99, C105, C106, C107, C108, C110: 100nF; C-0402; Voltage 50V; MFR. Part # CL05B104KB54PNC; JLCPCB Part # C307331
C59, C63, C67, C71, C92, C97, C98: 10nF; C-0402; Voltage 50V; MFR. Part # CL05B103KB5NNNC; JLCPCB Part # C15195
C80, C81, C82, C83, C84, C85, C86, C87, C88: 22uF; C-0805; Voltage 25V; MFR. Part # CL21A226MAQNNNE; JLCPCB Part # C45783
C89: 6.8pF; C-0402; Voltage 50V; MFR. Part # 0402CG6R8C500NT; JLCPCB Part # C1576
C90: 6.8nF; C-0402; Voltage 50V; MFR. Part # 0402B682K500NT; JLCPCB Part # C1542
C109, C111, C112, C113: 100pF; C-0402; Voltage 50V; MFR. Part # 0402CG101J500NT; JLCPCB Part # C1546
D18: B5819W; SOD-123; Reverse Voltage 40V; MFR. Part # B5819W SL; JLCPCB Part # C8598
L1: 22uH; L-7.1-6.6; MFR Part # SMMS0630-220M; JLCPCB Part # C128694
R36, R38, R40, R42, R61: 0R; R-0402; Tolerance 1%; MFR. Part # 0402WGF0000TCE; JLCPCB Part # C17168
R37, R41, R43, R56, R57, R58, R60, R62, R63, R64: 10K; R-0402; Tolerance 1%; MFR. Part # 0402WGF1002TCE; JLCPCB Part # C25744
R39, R52: 18K; R-0402; Tolerance 1%; MFR. Part # 0402WGF1802TCE; JLCPCB Part # C25762
R44, R46, R59, R65, R66, R67: 2.2K; R-0402; Tolerance 1%; MFR. Part # 0402WGF2201TCE; JLCPCB Part # C25879
R45, R53: 3.3K; R-0402; Tolerance 1%; MFR. Part # 0402WGF3301TCE; JLCPCB Part # C25890
R47: 4.7K; R-0402; Tolerance 1%; MFR. Part # 0402WGF4701TCE; JLCPCB Part # C25900
R48, R50: 1K; R-0402; Tolerance 1%; MFR. Part # 0402WGF1001TCE; JLCPCB Part # C11702
R49: 100R; R-0402; Tolerance 1%; MFR. Part # 0402WGF1000TCE; JLCPCB Part # C25076
R51: 680R; R-0402; Tolerance 1%; MFR. Part # 0402WGF6800TCE; JLCPCB Part # C25130
R54: 100K; R-0402; Tolerance 1%; MFR. Part # 0402WGF1003TCE; JLCPCB Part # C25741
R55: 200K; R-0402; Tolerance 1%; MFR. Part # 0402WGF2003TCE; JLCPCB Part # C25764
U3, U4, U5, U6: AP2127; SOT-23-5; Operating voltage 2.5V-6V; MFR Part # AP2127K-ADJTRG1; JLCPCB Part # C96343
U7: DRV8301; HTSSOP-56-EP; MFR Part # DRV8301DCA; Digikey Part # 296-33274-5-ND

Connections:
+2V5: C68.1, C69.1, C70.1, C71.1, R43.1, U6.5 (VOUT); also elsewhere on the board
+3.3VA: C64.1, C65.1, C66.1, C67.1, R41.1, U5.5 (VOUT); also elsewhere on the board
+3V3: C56.1, C57.1, C58.1, C59.1, C106.1, C107.1, C108.1, R37.1, R56.1, U3.5 (VOUT), U7.49 (VDD_SPI); also elsewhere on the board
+5V: C72.1, C73.1, C74.1, C75.1, C80.2, C82.2, C84.2, C86.2, C88.2, L1.1, R36.1, R38.1, R51.1, U3.1 (VIN), U4.1 (VIN); also elsewhere on the board
+5VA: C60.1, C61.1, C62.1, C63.1, C76.1, C77.1, C78.1, C79.1, R39.1, R40.1, R42.1, U4.5 (VOUT), U5.1 (VIN), U6.1 (VIN); also elsewhere on the board
/powerDrivers/CS: U7.8 (nSCS); also elsewhere on the board
/powerDrivers/EN_GATE: R57.2, U7.16 (EN_GATE); also elsewhere on the board
/powerDrivers/FAULT: R56.2, U7.6 (nFAULT); also elsewhere on the board
/powerDrivers/GH_A: U7.47 (GH_A); also elsewhere on the board
/powerDrivers/GH_B: U7.42 (GH_B); also elsewhere on the board
/powerDrivers/GH_C: U7.37 (GH_C); also elsewhere on the board
/powerDrivers/GL_A: U7.45 (GL_A); also elsewhere on the board
/powerDrivers/GL_B: U7.40 (GL_B); also elsewhere on the board
/powerDrivers/GL_C: U7.35 (GL_C); also elsewhere on the board
/powerDrivers/INH_A: U7.17 (INH_A); also elsewhere on the board
/powerDrivers/INH_B: U7.19 (INH_B); also elsewhere on the board
/powerDrivers/INH_C: U7.21 (INH_C); also elsewhere on the board
/powerDrivers/INL_A: U7.18 (INL_A); also elsewhere on the board
/powerDrivers/INL_B: U7.20 (INL_B); also elsewhere on the board
/powerDrivers/INL_C: U7.22 (INL_C); also elsewhere on the board
/powerDrivers/SCK: U7.11 (SCLK); also elsewhere on the board
/powerDrivers/SDI: U7.9 (SDI); also elsewhere on the board
/powerDrivers/SDO: U7.10 (SDO); also elsewhere on the board
/powerDrivers/SENS_A: C111.1, R62.2, R65.1; also elsewhere on the board
/powerDrivers/SENS_B: C112.1, R63.2, R66.1; also elsewhere on the board
/powerDrivers/SENS_C: C113.1, R64.2, R67.1; also elsewhere on the board
/powerDrivers/SENS_SUPPLY: C109.1, R58.2, R59.1; also elsewhere on the board
/powerDrivers/SH_A: C99.2, R62.1, U7.46 (SH_A); also elsewhere on the board
/powerDrivers/SH_B: C105.2, R63.1, U7.41 (SH_B); also elsewhere on the board
/powerDrivers/SH_C: C110.2, R64.1, U7.36 (SH_C); also elsewhere on the board
GND: C56.2, C57.2, C58.2, C59.2, C60.2, C61.2, C62.2, C63.2, C64.2, C65.2, C66.2, C67.2, C68.2, C69.2, C70.2, C71.2, C72.2, C73.2, C74.2, C75.2, C76.2, C77.2, C78.2, C79.2, C80.1, C81.2, C82.1, C83.2, C84.1, C85.2, C86.1, C87.2, C88.1, C89.2, C90.1, C92.1, C93.1, C94.2, C95.2, C96.2, C100.2, C101.2, C102.2, C103.2, C104.2, C106.2, C107.2, C108.2, C109.2, C111.2, C112.2, C113.2, D18.2 (A), R47.2, R48.2, R49.2, R50.2, R53.2, R55.1, R57.1, R59.2, R60.1, R65.2, R66.2, R67.2, U3.2 (GND), U4.2 (GND), U5.2 (GND), U6.2 (GND), U7.28 (AGND), U7.30 (SP2), U7.31 (SN2), U7.32 (SP1), U7.33 (SN1), U7.34 (SL_C), U7.39 (SL_B), U7.44 (SL_A), U7.57 (PWR_PAD); also elsewhere on the board
unnamed: C89.1, R54.2, U7.2 (COMP)
unnamed: C90.2, R54.1
unnamed: C91.1, U7.52 (BST_BK)
unnamed: C91.2, D18.1 (K), L1.2, U7.50 (PH), U7.51 (PH)
unnamed: C92.2, U7.56 (SS_TR)
unnamed: C93.2, U7.23 (DVDD)
unnamed: C94.1, C95.1, U7.13 (GVDD)
unnamed: C97.1, C98.1, U7.14 (CP1)
unnamed: C97.2, C98.2, U7.15 (CP2)
unnamed: C99.1, U7.48 (BST_A)
unnamed: C105.1, U7.43 (BST_B)
unnamed: C110.1, U7.38 (BST_C)
unnamed: R36.2, U3.3 (EN)
unnamed: R37.2, R44.1, U3.4 (ADJ)
unnamed: R38.2, U4.3 (EN)
unnamed: R39.2, R45.1, U4.4 (ADJ)
unnamed: R40.2, U5.3 (EN)
unnamed: R41.2, R46.1, U5.4 (ADJ)
unnamed: R42.2, U6.3 (EN)
unnamed: R43.2, R47.1, U6.4 (ADJ)
unnamed: R44.2, R48.1
unnamed: R45.2, R49.1
unnamed: R46.2, R50.1
unnamed: R51.2, R52.1
unnamed: R52.2, R53.1, U7.3 (VSENSE)
unnamed: R55.2, U7.1 (RT_CLK)
unnamed: R60.2, U7.7 (DTC)
unnamed: R61.2, U7.24 (REF)
PVDD2: C81.1, C83.1, C85.1, C87.1, C100.1, C101.1, C102.1, C103.1, C104.1, R58.1, U7.29 (PVDD1), U7.53 (PVDD2), U7.54 (PVDD2); also elsewhere on the board
VDDA: C96.1, R61.1, U7.27 (AVDD)

Notes on the sheet:
0.8V
Css_tr should remain lower than 0.47 μF and greater than 0.47 nF. Css_tr(nF) = (tss(ms)*Iss(mA)) / Vref(V)*0.8 Css_tr(nF) = (3.2*2) / 0.8*0.8 = 10nF @ 3.2ms
C PVDD1 : ≥4.7 μF (20%) ceramic, rated for PVDD1 datasheet @ page 15
fc= 27KHz
Internal Buck Converter: TPS54160
<—— That terminal has around +5.3V. To create low-noise +5V, we need a 300mV margin ——>
C DVDD : 1 μF (20%) ceramic, ≥6.3 V datasheet @ page 15
(14.7 / 4.7 ) * 0.8 = 2.502V
C PVDD2 : ≥4.7 μF (20%) ceramic, rated for PVDD2 datasheet @ page 17
(13.2 / 3.2 ) * 0.8 = 3.3V
R1 = R2 * ((Vout-0.8)/0.8) 18.68K = 3.3K * ((Vout-0.8)/0.8) Vout = 5.328V
C BST_X : 0.1 μF (20%) ceramic, ≥ 16 V datasheet @ page 15
C GVDD : 2.2 μF (20%) ceramic, ≥ 16 V datasheet @ page 15
(21.4 / 3.4 ) * 0.8 = 5.035V
C AVDD : 1 μF (20%) ceramic, ≥10 V datasheet @ page 15
The switching frequency: 100kHz to 2500kHz Rrt_clk(KOhm) = 206033 / fSW(kHz)^1.0888 = 206033 / 600^1.0888 = 194.57 KOhm
min Vdropout = 170 mV
C CP : 0.022 μF (20%) ceramic, rated for PVDD1 | datasheet @ page 15

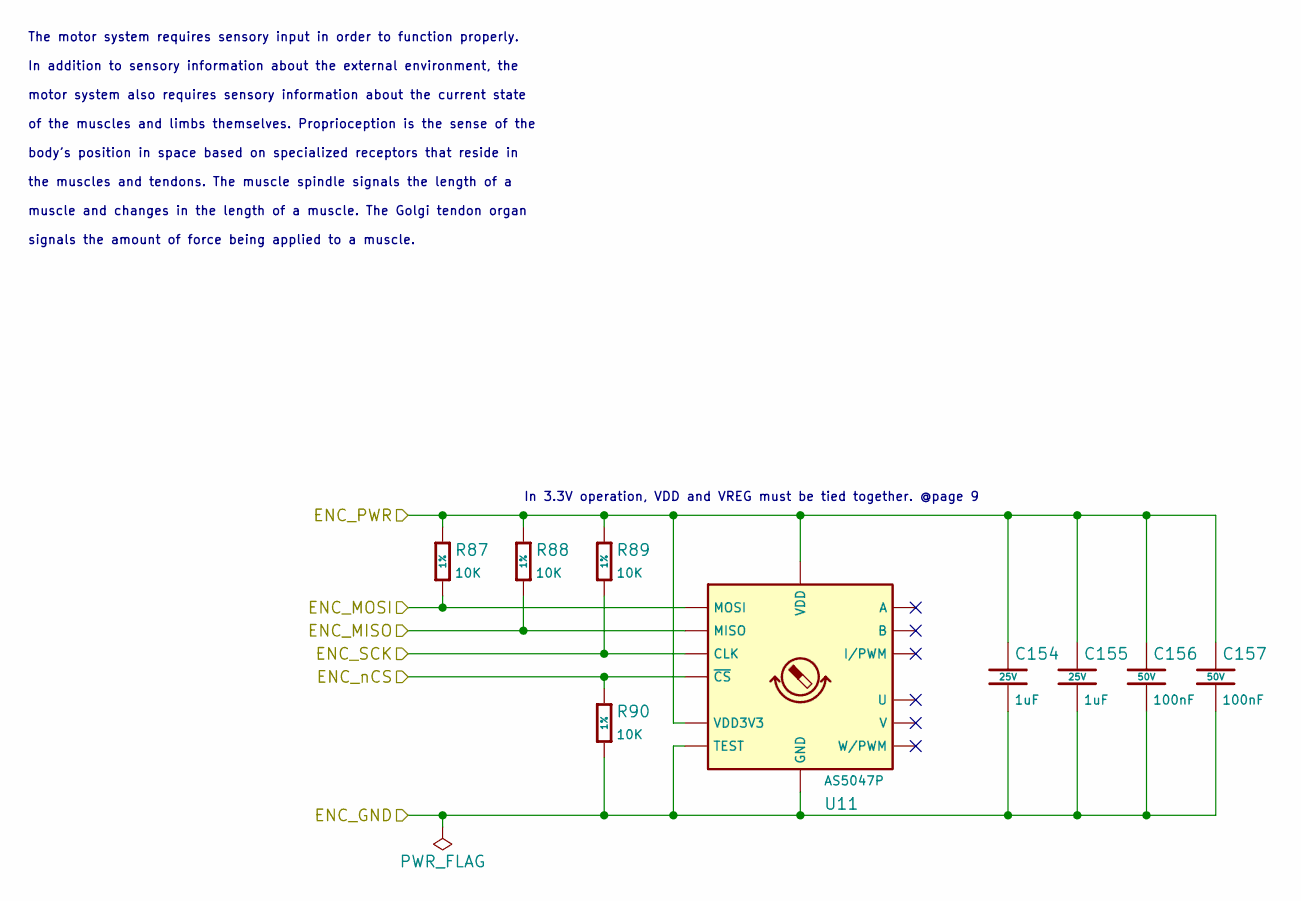
[picture p14: schematic golgi_tendon_organ.kicad_sch]

Parts:
C154, C155: 1uF; C-0402; Voltage 25V; MFR. Part # CL05A105KA5NQNC; JLCPCB Part # C52923
C156, C157: 100nF; C-0402; Voltage 50V; MFR. Part # CL05B104KB54PNC; JLCPCB Part # C307331
R87, R88, R89, R90: 10K; R-0402; Tolerance 1%; MFR. Part # 0402WGF1002TCE; JLCPCB Part # C25744
U11: AS5047P; TSSOP-14_4.4x5mm_P0.65mm; MFR Part # AS5047P-ATSM; Digikey Part # AS5047P-ATSMCT-ND

Connections:
/Proprioception/ENC_GND: C154.2, C155.2, C156.2, C157.2, R90.2, U11.5 (TEST), U11.13 (GND); also elsewhere on the board
/Proprioception/ENC_MISO: R88.2, U11.3 (MISO); also elsewhere on the board
/Proprioception/ENC_MOSI: R87.2, U11.4 (MOSI); also elsewhere on the board
/Proprioception/ENC_PWR: C154.1, C155.1, C156.1, C157.1, R87.1, R88.1, R89.1, U11.11 (VDD), U11.12 (VDD3V3); also elsewhere on the board
/Proprioception/ENC_SCK: R89.2, U11.2 (CLK); also elsewhere on the board
/Proprioception/ENC_nCS: R90.1, U11.1 (~CS); also elsewhere on the board

Notes on the sheet:
In 3.3V operation, VDD and VREG must be tied together. @page 9
The motor system requires sensory input in order to function properly. In addition to sensory information about the external environment, the motor system also requires sensory information about the current state of the muscles and limbs themselves. Proprioception is the sense of the body’s positio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

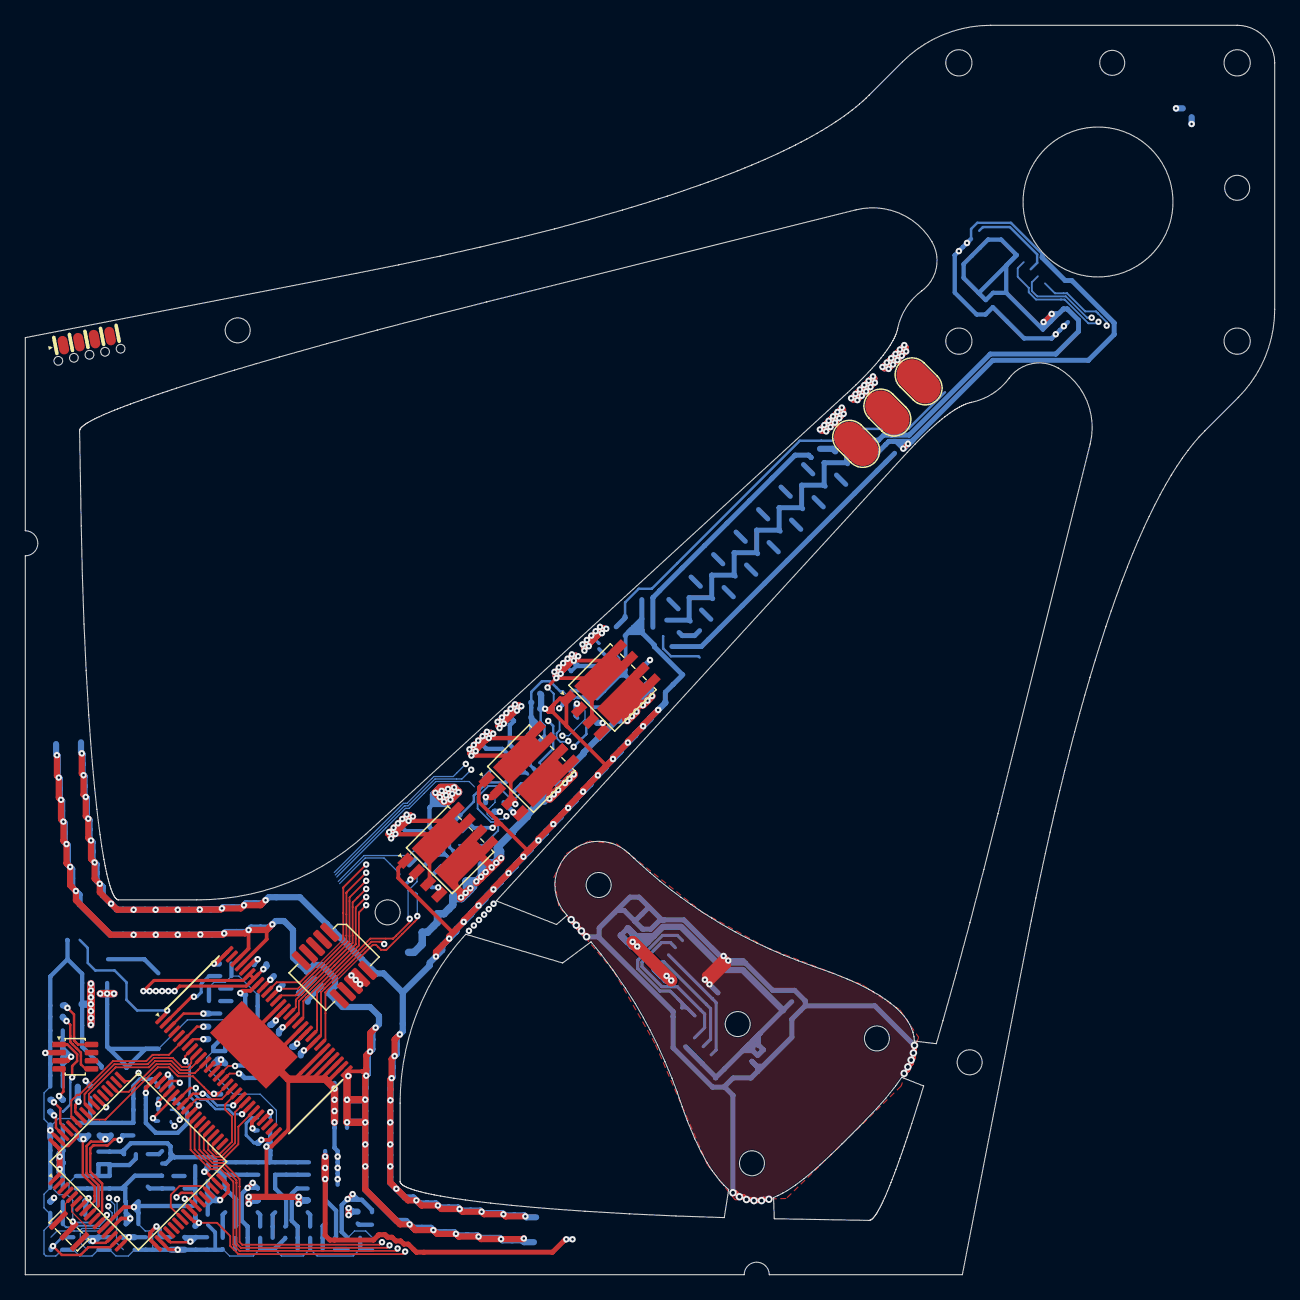
[picture p15: board pectoralis_major.kicad_pcb from above]

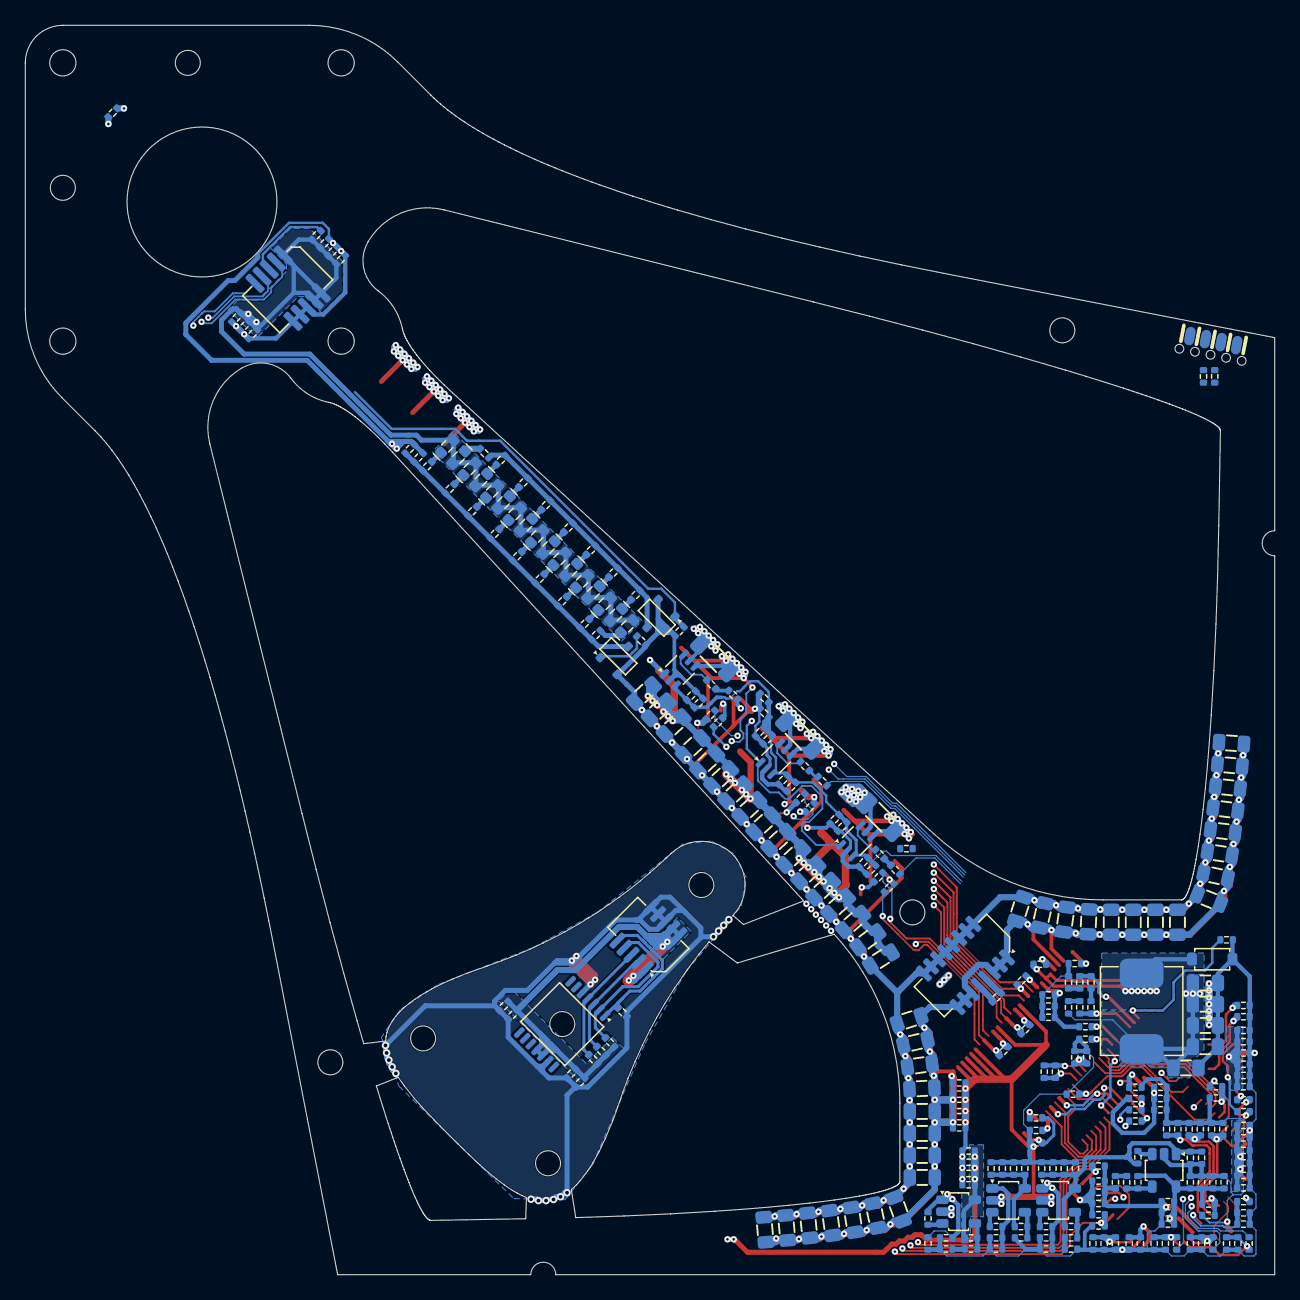
[picture p16: board pectoralis_major.kicad_pcb from below]

Board: 4 copper layers, 100.0 x 100.0 mm, 293 parts (281 on the bottom side), 136 nets.
