Merophy/pectoralis_major/(commit log)

2022-02-15 initialized the circuit design files
    [mitochondria.sch, myofibril.sch, neuromuscular_junction.sch, nucleus.sch, pectoralis_major.kicad_pcb, pectoralis_major.sch]
2022-02-17 added the MCU, duplicated the LEDs for bottom side, changed the can driver to tcan330
    [neuromuscular_junction.sch, nucleus.sch]
2022-02-17 added buck converter's components
    [mitochondria.sch]
2022-02-19 added motor driver and adjustable regulators. Now, it is the time to start the detailed review
    [mitochondria.sch, nucleus.sch]
2022-02-19 created golgi_tendon_organ page
    [golgi_tendon_organ.sch, mitochondria.sch, myofibril.sch, neuromuscular_junction.sch, nucleus.sch, pectoralis_major.sch]
2022-02-19 added hal sensor
    [golgi_tendon_organ.sch, pectoralis_major.sch]
2022-02-20 added servo control input feature
    [neuromuscular_junction.sch, nucleus.sch, pectoralis_major.sch]
2022-02-20 edited myofibril file, added a related image about myofibrils
    [mitochondria.sch, myofibril.sch, neuromuscular_junction.sch, nucleus.sch]
2022-02-21 edited the buck converter in the motor driver IC
    [mitochondria.sch]
2022-02-25 tuned the compansation at the buck driver
    [mitochondria.sch]
2022-02-25 migration! KiCad 6.0
    [golgi_tendon_organ.kicad_sch, mitochondria.kicad_sch, myofibril.kicad_sch, neuromuscular_junction.kicad_sch, nucleus.kicad_sch, pectoralis_major.kicad_pcb, pectoralis_major.kicad_sch]
2022-02-28 deleted previous version files
    [golgi_tendon_organ.kicad_sch, golgi_tendon_organ.sch, mitochondria.kicad_sch, mitochondria.sch, myofibril.kicad_sch, myofibril.sch, neuromuscular_junction.kicad_sch, neuromuscular_junction.sch]
2022-03-01 changed the LED packages, edited field reference positions
    [mitochondria.kicad_sch, myofibril.kicad_sch, neuromuscular_junction.kicad_sch, nucleus.kicad_sch, pectoralis_major.kicad_sch]
2022-03-02 added a diode package to the libs
    [mitochondria.kicad_sch, myofibril.kicad_sch, pectoralis_major.kicad_sch]
2022-03-03 created and added the packages called SOT-23-5 and SOT-23-8 to the libraries
    [golgi_tendon_organ.kicad_sch, mitochondria.kicad_sch, myofibril.kicad_sch, neuromuscular_junction.kicad_sch, pectoralis_major.kicad_sch]
2022-03-04 edited the motor driver's and the current amplifier's packages
    [mitochondria.kicad_sch, myofibril.kicad_sch, nucleus.kicad_sch, pectoralis_major.kicad_sch]
2022-03-05 added last Small-Outline packaged component to the library and updated the design
    [golgi_tendon_organ.kicad_sch, myofibril.kicad_sch, pectoralis_major.kicad_sch]
2022-03-06 done all the packages and migrations. Now, time to start to route the module
    [esc.DXF, golgi_tendon_organ.kicad_sch, mitochondria.kicad_sch, myofibril.kicad_sch, neuromuscular_junction.kicad_sch, nucleus.kicad_sch, pectoralis_major.kicad_pcb, pectoralis_major.kicad_sch]
2022-03-09 placed LEDs, mosfets, bulk capacitors
    [mitochondria.kicad_sch, myofibril.kicad_sch, pectoralis_major.kicad_pcb]
2022-03-12 placed current shunt circuits and mosfets
    [myofibril.kicad_sch, pectoralis_major.kicad_pcb]
2022-03-12 First placement of the MCU Page's components are done
    [mitochondria.kicad_sch, neuromuscular_junction.kicad_sch, pectoralis_major.kicad_pcb, pectoralis_major.kicad_sch]
2022-03-12 placing all the regulators are done
    [mitochondria.kicad_sch, pectoralis_major.kicad_pcb, pectoralis_major.kicad_sch]
2022-03-12 placed all the components except magnetic sensor board
    [pectoralis_major.kicad_pcb]
2022-03-12 drew the traces in the light section
    [pectoralis_major.kicad_pcb]
2022-03-30 done placing and routing of the golgi tendon organ
    [foc.DXF, pectoralis_major.kicad_pcb]
2022-03-31 done the connection between the MCU and the motor driver
    [nucleus.kicad_sch, pectoralis_major.kicad_pcb, pectoralis_major.kicad_sch]
2022-04-10 done all the tracing between the driver and the mosfets
    [nucleus.kicad_sch, pectoralis_major.kicad_pcb, pectoralis_major.kicad_sch]
2022-04-14 done mosfet tracing
    [pectoralis_major.kicad_pcb]
